limonen-robot/SuperMEXE02/hardware/README.md

# SuperMEXE02 回路図

KiCad 10で **[SuperMEXE02.kicad_pro](SuperMEXE02.kicad_pro)** を開き、回路図エディターを起動してください。回路図・プロジェクト専用シンボル・ライブラリー設定は同じフォルダーに揃っています。

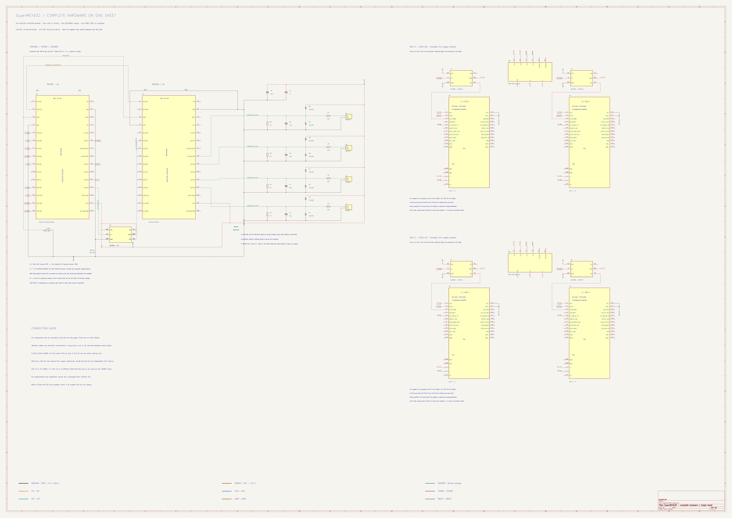
[picture p1: hardware/previews/sensor_frontend.png]
motor・sensorと基板間配線


**A0横の1ページに、すべての部品を統合しました。** 左側に両G431KB・4入力・共通リセット・UART・VCTリレー、右上にA/B軸と電源PS1、右下にC/D軸と電源PS2を配置しています。子ページはありません。同じラベル名は同じ電気接続を表します。KiCadまたはSVGを拡大して全ピンを確認してください。

[AZD-Kの全端子と配線](AZD_K_WIRING.md)／[基板間配線と未確定事項](INTERCONNECTS.md)。接続内容・部品定数・ピン割当は3ページ版から変更していません。ファームウェアとPCアプリも変更していません。

## 追加：すべての線をつないだ配線図

元の図の配置とラベル接続を残し、マイコンから全接続先まで線を追える[連続配線図](continuous_wiring/README.md)を別に追加しました。開くファイルは `continuous_wiring/SuperMEXE02_Continuous.kicad_pro` です。信号・電源・GNDをラベルで省略せず描いています。両図の電気的な接続内容は同じです。

## 文字だけで回路を再構成する仕様

**[回路・配線の再現仕様](HARDWARE_REPRODUCTION.md)** に、部品・型番・値、全278ピンと全34ネットの接続先、外部配線未記載131ピン、基板の向き、信号分類、配線手順をまとめました。[汎用JSON](wiring_manifest.json)、[接続CSV](wiring_connections.csv)、[部品CSV](hardware_bom.csv)を用意し、KiCad以外の回路CADや作図プログラムでも再構成できる形式にしています。元ファイルのハッシュは出典確認用の補足です。図面の外部接続を再現する資料であり、センサー型番やブレーキ・電源内部設定など実機の完全複製に必要な不足情報も明記しています。

## 配線の色

元図と連続配線図の両方で、信号の種類ごとに同じ色を使います。CW＝オレンジ、CCW＝青、センサー信号＝緑、ZHOME＝赤紫、VCT＝青緑、通信＝茶、リセット＝灰、電源＋＝赤、GND／電源−＝黒です。図の下端にも色見本を付けました。

同じ色でも別の電源・別の軸は別の接続です。配線と電源の分離は変更していません。色設定を読み込むには、このフォルダーの **SuperMEXE02.kicad_pro** から開いてください。[配色表と表示設定の説明](continuous_wiring/README.md#配線の色)を参照。

## 現在の範囲

2026-11-13の利用者説明と提供図をもとに、sensor側4入力と両マイコン間の実配線を記録しています。motorのCW/CCW、ZHOME用リレー4枚、MDR-100-24電源2台も記載しています。

| 図中名 | アプリ系列 | MCU入力 | 510 Ω直列 | 47 kΩ対GND | 0.1 µF対GND | 下側／上側1N4148 |
|---|---|---|---|---|---|---|
| sensor1 | a | PA_0 | R1 | R3 | C1 | D1／D3 |
| sensor2 | b | PA_1 | R2 | R4 | C2 | D2／D4 |
| sensor3 | c | PA_4 | R5 | R6 | C5 | D5／D6 |
| sensor4 | d | PA_5 | R7 | R8 | C6 | D7／D8 |

Pressure／Flow／Flow1はsensor1／2／3に変更し、同じ回路をsensor4として追加しました。圧力・流量などの意味と換算はアプリ側で設定します。C3=0.1 µF、C4=1 µFも提供図から引き継いでいます。

センサーのIN側は意図的な省略です。励起・センサー電源の配線は描いていません。両NUCLEOは現在USB給電です。両基板の3V3端子同士とGNDは共通化済みとの利用者説明を反映しました。USBを含む内部の給電経路は未検証です。

U1・U2は左CN4・右CN3をそれぞれ上から1〜15番で配置した基板シンボルです。Arduino名とMCU信号名を併記し、ピン番号は `4.n` = CN4-n、`3.n` = CN3-nです。[全端子対応表](NUCLEO_G431KB_PINOUT.md)に公式資料と接続先を示します。×印はこの図に外部配線を記載していない端子を示し、motorの未説明端子も含みます。S1〜S4は引き続き論理OUT/GNDだけの機能シンボルで、コネクターの物理番号は未指定です。フットプリントとPCBはまだ作っていません。PA_5をA4から使う際のソルダーブリッジとPB_7との共有状態は実ボードで確認が必要です。

## PB0の意味

現行[sensorコード](../G431KB_sensor/main.cpp)はPB_0を`InterruptIn`として使い、内部PullDownを設定して立ち上がりを検出します。VCTを受けた時刻を基準に、設定時間後のADC取得を予約します。初期遅延は310000 µs（310 ms）で、アプリから系列ごとに変更できます。100 Hzの通常取得は別に動作します。

実配線は **motor PA_0 → K1リレー基板の制御入力**、**共通3V3 → リレー接点 → sensor PB_0** です。PA0 HighでPB0に3.3 Vが入ります。motor自身のPB_0はB軸CWで、sensor PB_0とは別の信号です。

旧`ColonaryArtery_FlwPrsReader/main.cpp`では、PB_0の立ち上がりから310 ms後の左室圧（PA_5）を取得し、直近2回を平均して左室拡張末期圧相当値として扱っていました。現在はその時刻指定取得を汎用化しています。

## 写真から確認した機器

| 機器 | 判読した型番・表示 | まだ決めていないこと |
|---|---|---|
| DC電源 | MEAN WELL **MDR-100-24**、出力24 V・4 A（96 W）、入力100–240 VAC | PS1=A/B、PS2=C/Dを確認済み。AC/PE・ブレーキ配線は未記載 |
| リレー本体 | BESTEP **JQC3F-03VDC-C**（DC 3 Vコイル表記）、接点10 A・250 VAC／30 VDC等の表示 | 基板はQCCAN QC19004、3/3.3 V High入力・端子順を確認済み。内部ジャンパー設定は未確認 |

電源銘板の「DC OK max.30 VDC/1 A」は状態出力接点の定格です。24 V主出力の定格とは別です。[MEAN WELL公式仕様書](https://www.meanwell.com/Upload/PDF/MDR-100/MDR-100-SPEC.PDF)を参照。

リレーのコイル3 Vという表記だけで、モジュールの入力電圧や3.3 V GPIOとの適合性は確定しません。写真にはPC817C表記の部品も見えますが、絶縁構成・ジャンパー設定は未確認です。今回、VCT用1枚とZHOME用4枚を全6端子で表示しました。VCC/GNDは共通3V3/マイコンGNDへ接続し、接点側はVCTでは3V3、ZHOMEでは24 Vを扱います。内部のジャンパー設定は未確定です。

写真の根拠：2026-11-13に利用者が提供した電源銘板、リレー表面・裏面の3画像。型番の読み取りを記録したもので、基板全体の回路を推定したものではありません。

## ファイルと検証

- `SuperMEXE02.kicad_pro`：開くプロジェクト。
- `SuperMEXE02.kicad_sch`：全機器を配置した1ページの回路図。
- [AZD-K・リレー・電源の詳細](AZD_K_WIRING.md)：全端子表、IN-COMの説明、分配と未記載事項。
- `SuperMEXE02_IO.kicad_sym` / `sym-lib-table`：プロジェクト専用シンボルと相対パス設定。
- `sensor_channels.json`：チャンネルと部品番号・ヘッダーピンの対応。
- `nucleo_g431kb_pinout.json` / [全端子対応表](NUCLEO_G431KB_PINOUT.md)：全30端子の配置と信号名。
- `previews/`：1ページ全体のSVG・PNGプレビュー。
- `verify_connections.py`：KiCad XMLネットリストと確認済み配線の照合。
- [検証記録](checks/README.md)：ERCとネットリスト照合。

元の回路定数を再現した段階であり、センサーの出力範囲・保護性能・実配線の適合確認は今後行います。ファームウェアとPCアプリは今回変更していません。
