limonen-robot/SuperMEXE02/hardware/checks/README.md

# 回路図の確認記録

2026-11-13、KiCad 10.0.8で確認。

- 回路図読込み・SVG出力・XMLネットリスト出力：成功。
- ERC：エラー0、警告0。詳細は同梱レポート参照。
- XMLネットリスト照合：4つのADCネットが独立し、各ネットに対象GPIO・510 Ω抵抗出力・0.1 µF上端・47 kΩ上端・上下ダイオードの正しい極が接続されていることを確認。
- 各sensor OUTは対応する510 Ωの入力側だけへ接続。下側ダイオードのアノードはGND、上側ダイオードのカソードは3V3。
- C3/C4と上下クランプの共通3V3/GND接続も確認。
- Rev 0.2：G431KBまでの直接配線、共通3V3/GNDラインへ配置変更。変更前後の全11ネットについて、全ての部品ピンの接続先が完全一致することを確認。
- Rev 0.3：左右15本ずつ全30端子の重複・欠落なし。公式UM2397 Figure 12/Table 11に対応させ、既存の論理GPIO名から物理ヘッダー端子へ変換後、全11ネットの接続先を照合して一致。GNDはCN3-2とCN4-4の両方へ接続。
- Rev 0.4：U1/U2各30端子、D1→D0の2端子だけの接続、NRST2端子とSW1の接続、GND/3V3の共有、PA0→K1 IN・K1 NO→PB0の独立ネット、K1 COM→3V3をXMLネットリストで照合。4入力の既存ネットは完全一致。
- Rev 0.5：3ページの階層を含むERC 0/0。4台のCN4全24端子・CN1全5点、リレー5枚×6端子、電源2台×9端子を確認。12本の軸制御信号、各リレーNO→IN4、IN-COM5→各24 V−、CW/CCW−→マイコンGND、3つの基準線が別ネットであることを検証スクリプトで照合。
- Rev 0.6：階層を廃止してA0横1ページへ統合。XMLネットリストの全ネットを部品ピンの集合で比較し、3ページ版と完全一致。シート数1、部品番号の重複なし、ERC 0/0、配線照合スクリプト成功を確認。
- PNGで文字・部品・配線の配置を目視確認。

ERCは回路図上の接続検査であり、実配線の一致、ADC保護性能、基板の端子割当、センサー適合性を検証するものではない。VCTのリレー経由配線は利用者説明を反映。リレー基板は全6端子を反映済み。内部ジャンパー・USBを含む電源経路の適否・3.3 V直結パルス入力の適合性は未検証。

再確認例（このhardwareフォルダーで実行。KiCadのbinをPATHに追加）：

```powershell
kicad-cli sch erc --severity-all -o checks/sensor_frontend.erc.rpt SuperMEXE02.kicad_sch
kicad-cli sch export svg -o previews SuperMEXE02.kicad_sch
kicad-cli sch export netlist --format kicadxml -o sensor_frontend.net.xml SuperMEXE02.kicad_sch
```

配線照合の再実行：

```powershell
kicad-cli sch export netlist --format kicadxml -o hardware.net.xml SuperMEXE02.kicad_sch
python verify_connections.py hardware.net.xml
```

## 両図の配色統一（2026-11-14）

- 利用者指定：CWをオレンジ、CCWを青、センサーを緑に統一。ZHOMEはCWと区別するため赤紫へ変更。
- 元図・連続図それぞれの接続済み34ネットについて、KiCad出力のネットクラスが指定分類と一致することを確認。
- 両図の全ネットの部品ピン集合は、今回の変更前と完全一致。4軸GPIO・ADC・IN-COM5・UART・共通リセット・電源分離の既存検査に合格。
- 連続図は299本の線分だけによる接続検査にも合格。両図のERCはエラー0・警告0。
- SVGで全9色の配線出力を確認し、PNGで凡例と全体配置を目視確認。ファームウェア・PCアプリは変更なし。

## 文字による再現仕様の照合（2026-11-14）

- 対象回路コミット `f86a550`。今回は文書と汎用データのみ更新し、回路図・ライブラリー・ファームウェア・PCアプリは変更していない。
- `HARDWARE_REPRODUCTION.md`、`wiring_manifest.json`、`wiring_connections.csv`、`hardware_bom.csv`を照合。40部品・278ピン・接続済み34ネット・外部配線未記載131ピンの一致を確認。
- Markdown本文の全ネット表・部品別ピン表を読み戻してJSONと比較。CSVから読み戻した端子集合も一致し、部品CSVの抵抗値（Ω）・容量（F）・ピン数をJSONと比較して一致。
- 元図・連続図から新規出力したXMLネットリストと、文書データの全端子集合が完全一致。接続済みと未記載の重複・漏れなし。
- 両図・専用ライブラリー・ライブラリー参照設定の計8ファイルのSHA-256と、文書中の相対ファイルリンクを確認。
- 既存の配線検査と、連続図299線分の幾何学的接続検査にも合格。
- 外部端子付きモジュールとしての回路再構成を対象とする。内部回路・実パラメータ・機械構造などの不足情報は再現仕様の第10節に明記。
