limonen-robot/SuperMEXE02/hardware/HARDWARE_REPRODUCTION.md

# SuperMEXE02 回路・配線の文字による再現仕様

更新日：2026-11-14。対象回路はコミット `f86a550`。以後の文書追加で回路・コードは変更していない。

## 1. 再現できる範囲と読解規則

**KiCad・他の回路CAD・独自の作図プログラム・手描きのいずれでも再構成するための、ツール共通仕様**である。この文書だけで、現行図面に記録した部品・定数・全端子・全ネット・非接続表示・配色を再構成できる。ここでいう「同じ回路」は**図面に記録された外部端子間の電気的接続**を指す。実機の内部設定・機械構造を含めた完全複製は、第10節の不足情報が確定するまでできない。未知の値を一般的な接続やメーカー初期値で補わない。

- U1=sensor、U2=motor。両方ともST NUCLEO-G431KB。同じPA0等でも別基板のピンは別物。
- NUCLEOは部品面を上から見てUSBを上に置く。左CN4、右CN3、両列とも上から1〜15。`3.12`=CN3-12、`4.1`=CN4-1。MCUチップのパッケージ番号ではない。
- AZD-Kの`4.n`=CN4-n、`1.+`=CN1の＋、`1.-`=CN1の−、`1.MB1`等はメーカーの文字端子。CN4の図上配置は左1〜12、右13〜24（各列上から）。実コネクターの差込面/電線側の向きまで図から推定しない。
- ピン識別子は文字列として扱う。例えば`3.10`を小数3.1へ変換しない。CADの表示番号に使えない場合は別の内部番号を付け、元の文字列と1対1対応を残す。
- 内部回路を省略したモジュールは、ここに列挙した外部端子だけを持つ四角いブロックで再現してよい。専用シンボルライブラリーは必須でない。部品内部の結線・共通ピンは未記録の範囲まで補わない。
- 同じN番号の端子は**すべて同一ネット**。別のN番号同士を短絡しない。N番号は本書の識別子で、メーカー端子番号ではない。
- 第8節の各部品表には全ピンを1回ずつ記す。「未記載/×」は図面で外部接続を付けていない状態。実機で未使用とは断定しない。
- リレーのINとNO、VCCとCOMは別端子。リレーが閉じたときだけCOM–NOが導通する。図のネット表ではCOMとNOを永久短絡しない。内部コイル・フォトカプラ・ジャンパーは展開しない。
- ダイオード`1=K（カソード/帯側）`、`2=A（アノード）`。コンデンサーは図上無極性の2端子。抵抗の1/2は図面上の識別。
- PWR_FLAG・GND・+3V3の電源記号は実装部品でない。同じ名称の接続を定義する補助記号で、USB内部回路を意味しない。
- 色は信号分類。配線の実色を確認した記録ではなく、同色でも異なる電圧・異なるネットがある。

## 2. 機器・部品と図面識別

| 参照名 | 図面上の値/型番 | 役割 | シンボル |
|---|---|---|---|
| C1 | 0.1u | ADC入力からGNDへの0.1 µF | `Device:C` |
| C2 | 0.1u | ADC入力からGNDへの0.1 µF | `Device:C` |
| C3 | 0.1u | 3V3電源デカップリング | `Device:C` |
| C4 | 1u | 3V3電源デカップリング | `Device:C` |
| C5 | 0.1u | ADC入力からGNDへの0.1 µF | `Device:C` |
| C6 | 0.1u | ADC入力からGNDへの0.1 µF | `Device:C` |
| D1 | 1N4148 | GND側クランプ（A→GND） | `Diode:1N4148` |
| D2 | 1N4148 | GND側クランプ（A→GND） | `Diode:1N4148` |
| D3 | 1N4148 | 3V3側クランプ（K→3V3） | `Diode:1N4148` |
| D4 | 1N4148 | 3V3側クランプ（K→3V3） | `Diode:1N4148` |
| D5 | 1N4148 | GND側クランプ（A→GND） | `Diode:1N4148` |
| D6 | 1N4148 | 3V3側クランプ（K→3V3） | `Diode:1N4148` |
| D7 | 1N4148 | GND側クランプ（A→GND） | `Diode:1N4148` |
| D8 | 1N4148 | 3V3側クランプ（K→3V3） | `Diode:1N4148` |
| K1 | QC19004 / VCT | VCT用リレー基板 | `SuperMEXE02_IO:VCT_RELAY_MODULE` |
| K2 | QC19004 / ZHOME A | A軸ZHOME用リレー基板 | `SuperMEXE02_IO:VCT_RELAY_MODULE` |
| K3 | QC19004 / ZHOME B | B軸ZHOME用リレー基板 | `SuperMEXE02_IO:VCT_RELAY_MODULE` |
| K4 | QC19004 / ZHOME C | C軸ZHOME用リレー基板 | `SuperMEXE02_IO:VCT_RELAY_MODULE` |
| K5 | QC19004 / ZHOME D | D軸ZHOME用リレー基板 | `SuperMEXE02_IO:VCT_RELAY_MODULE` |
| PS1 | MDR-100-24 / AB | A/B軸用24 V電源 | `SuperMEXE02_IO:MDR_100_24` |
| PS2 | MDR-100-24 / CD | C/D軸用24 V電源 | `SuperMEXE02_IO:MDR_100_24` |
| R1 | 510 | 510 Ω直列抵抗 | `Device:R` |
| R2 | 510 | 510 Ω直列抵抗 | `Device:R` |
| R3 | 47k | 47 kΩ対GND抵抗 | `Device:R` |
| R4 | 47k | 47 kΩ対GND抵抗 | `Device:R` |
| R5 | 510 | 510 Ω直列抵抗 | `Device:R` |
| R6 | 47k | 47 kΩ対GND抵抗 | `Device:R` |
| R7 | 510 | 510 Ω直列抵抗 | `Device:R` |
| R8 | 47k | 47 kΩ対GND抵抗 | `Device:R` |
| S1 | sensor1 | sensor1の論理OUT/GND端子。実センサー型番・コネクター未指定 | `SuperMEXE02_IO:SensorInterface` |
| S2 | sensor2 | sensor2の論理OUT/GND端子。実センサー型番・コネクター未指定 | `SuperMEXE02_IO:SensorInterface` |
| S3 | sensor3 | sensor3の論理OUT/GND端子。実センサー型番・コネクター未指定 | `SuperMEXE02_IO:SensorInterface` |
| S4 | sensor4 | sensor4の論理OUT/GND端子。実センサー型番・コネクター未指定 | `SuperMEXE02_IO:SensorInterface` |
| SW1 | RESET BOTH | 両マイコン共通リセット用・通常開押しボタン | `Switch:SW_Push` |
| U1 | NUCLEO-G431KB | sensor用マイコン | `SuperMEXE02_IO:NUCLEO_G431KB_FULL` |
| U2 | NUCLEO-G431KB (motor) | motor用マイコン | `SuperMEXE02_IO:NUCLEO_G431KB_MOTOR_FULL` |
| U3 | AZD-K / A | A軸ドライバ | `SuperMEXE02_IO:AZD_K` |
| U4 | AZD-K / B | B軸ドライバ | `SuperMEXE02_IO:AZD_K` |
| U5 | AZD-K / C | C軸ドライバ | `SuperMEXE02_IO:AZD_K` |
| U6 | AZD-K / D | D軸ドライバ | `SuperMEXE02_IO:AZD_K` |

実機に対応する追加情報：

- U3〜U6はオリエンタルモーターAZD-K（AZD-KDではない）。各軸の直動機構は利用者指定のDRS2/AZ付き `DRSM42RG-04A2AZMK`。アクチュエータそのものを電気図の追加U番号として数えない。
- K1〜K5はQCCAN QC19004、ASIN B09X1P3YHLの1ch・3/3.3 V・High入力リレー基板。本体表示BESTEP JQC3F-03VDC-C。裸リレーをGPIO直結する意味ではない。部品面・制御側を左とした物理順は左上→下=VCC,IN,GND、右上→下=NC,COM,NO。1〜6という物理番号は付けていない。
- PS1/PS2はMEAN WELL MDR-100-24、24 V/4 A（96 W）。上側左→右=+V,+V,−V,−V,DC OK,DC OK、下側左→右=PE,N,L。本書では上側を+V1,+V2,−V1,−V2,OK1,OK2と識別する。同一電源内の+V1/+V2、−V1/−V2は内部共通。
- 抵抗は510 Ω×4、47 kΩ×4。C1/C2/C3/C5/C6=0.1 µF×5、C4=1 µF×1、1N4148×8。許容差・定格・実装形式は未指定。

## 3. 接続を組み立てる順序

1. U1/U2と全端子を第8節どおり定義する。両NUCLEOはST-LINK側USBからそれぞれ給電しPCへつなぐ構成。USB内部は省略する。
2. 共通+3V3とマイコンGNDを接続する。U1/U2のCN3-14を共有し、CN3-2/CN4-4を共通GNDとする。USBと3V3共有は既存配線の記録で、内部給電設定の検証済み設計ではない。
3. sensor入力4系統を第4節どおり組む。センサーIN・給電は省略範囲であり、+3V3へ勝手に接続しない。
4. motor GPIO→CW+/CCW+、CW−/CCW−→マイコンGNDを接続する。途中の外付け抵抗・トランジスタ・変換基板はない。
5. 各軸のZHOME用リレーを接続する。VCC/GNDはマイコン側、COM/NOは24 V側。
6. PS1をA/B、PS2をC/Dへ分配する。0V_AB、0V_CD、マイコンGNDの3種類は相互に接続しない。
7. K1によるVCT同期、U1 D1→U2 D0の線、NRST共通スイッチを接続する。
8. 第7節のネットを全件照合し、第8節の未記載端子へ追加配線していないことを確認する。

## 4. アナログ入力4系統

| 系列 | OUT→直列抵抗 | ADC先（U1） | ADC点→GND | 下クランプ（K→ADC/A→GND） | 上クランプ（K→3V3/A→ADC） |
|---|---|---|---|---|---|
| sensor1=a | S1.OUT→R1.1、R1.2→ADC点 | CN3-12 / A0 / PA0 | R3=47 kΩ、C1=0.1 µF | D1 | D3 |
| sensor2=b | S2.OUT→R2.1、R2.2→ADC点 | CN3-11 / A1 / PA1 | R4=47 kΩ、C2=0.1 µF | D2 | D4 |
| sensor3=c | S3.OUT→R5.1、R5.2→ADC点 | CN3-9 / A3 / PA4 | R6=47 kΩ、C5=0.1 µF | D5 | D6 |
| sensor4=d | S4.OUT→R7.1、R7.2→ADC点 | CN3-8 / A4 / PA5 | R8=47 kΩ、C6=0.1 µF | D7 | D8 |

全直列抵抗は510 Ω。各S.GNDはマイコンGND。C3（0.1 µF）とC4（1 µF）は各1番が共通3V3、各2番がGND。圧力/流量の用途は固定せずa〜dに対応する。PA5と端子A4を一致させる実ソルダーブリッジ設定は未記録。

## 5. モータ・ZHOME・電源の割当

| 軸 | CW（U2→ドライバCN4-1） | CCW（U2→CN4-2） | ZHOME（U2→リレーIN） | ドライバ/リレー/電源 |
|---|---|---|---|---|
| A | CN3-11 / A1 / PA1 | CN3-9 / A3 / PA4 | CN4-15 / D12 / PB4 | U3 / K2 / PS1 |
| B | CN4-6 / D3 / PB0 | CN4-12 / D9 / PA8 | CN4-14 / D11 / PB5 | U4 / K3 / PS1 |
| C | CN4-9 / D6 / PB6 | CN4-7 / D4 / PB7 | CN3-6 / A6 / PA7 | U5 / K4 / PS2 |
| D | CN4-13 / D10 / PA11 | CN4-5 / D2 / PA12 | CN4-8 / D5 / PA15 | U6 / K5 / PS2 |

全軸でCN4-13=CW−とCN4-14=CCW−はマイコンGND。リレーVCC=共通3V3、GND=マイコンGND、COM=対応電源の24 V＋、NO=ドライバCN4-3/IN4/ZHOME。CN4-5/IN-COM[4–7]とCN1−は対応電源の24 V−へ、CN1＋は対応24 V＋へ接続する。**CN4-22/GNDではなくCN4-5へ戻す。** CN4-17/IN-COM[8–9]もCN4-22も、この図では外部配線未記載。

図面上の端子識別子で表した分配は、PS1の+V1からU3.CN1＋とK2.COM、+V2からU4.CN1＋とK3.COM、−V1からU3.CN1−とU3.CN4-5、−V2からU4.CN1−とU4.CN4-5。PS2も同様にU5/K4、U6/K5へ接続する。1穴2本の実配線を表現しているが、実機の左右どちらの穴を各軸へ割り当てたかは未記録。同一電源内の同極穴は電気的に共通。線径や端末処理・端子仕様との適合は未確認。元図は同名ラベル、連続図は電源枠内の線で内部共通を表現する。

採用換算は実験的に確認された2500 pulse/mm（1 pulse=0.0004 mm）、CW正/CCW負。旧根拠4 mm/rev・10000 pulse/revを機械リードや別のギヤ設定へ置き換えない。機械リード・電子ギヤ設定・実方向の未確定事項は残る。

## 6. 基板間・PCとの接続

- VCT制御：U2.CN3-12/A0/PA0→K1.IN。K1.VCCとK1.COM=共通3V3、K1.GND=マイコンGND、K1.NO→U1.CN4-6/D3/PB0。K1.NCは未接続表示。PA0 Highで接点が閉じ3.3 Vがsensor PB0へ入る。**PA0→PB0の直結線を追加しない。**
- UART：U1.CN4-1/D1/PA9→U2.CN4-2/D0/PA10の1本。逆方向の線は記録なし。現行コードはこの線を使用せず、値はPC経由。元の冠流量システムの線伝送と混同しない。
- リセット：U1.CN4-3とU2.CN4-3をSW1.1へ、SW1.2をマイコンGNDへ。通常開、押すとLowとなり両ボードをリセット。右CN3-3は図上外部配線未記載で、左NRSTに加えて外部ジャンパーを追加しない。
- PC：両ボードへそれぞれUSB/ST-LINK VCP。motorはMOTOR_V6、sensorはSENSOR_V1、各115200 bps/8N1/フロー制御なし。COM番号・ドライブ文字は固定しない。
- sensor PB0の入力PullDownはファームウェア設定。図面に外付けプルダウン抵抗を追加しない。接点の遅延・チャタリング補正は現行コードにない。

## 7. 全接続ネット一覧（接続先の省略なし）

接続済み34ネット。各セルはそのネットの端子を全て列挙する。ネット名に含まれる先頭`/`はKiCadのシートパス。元図と連続図は自動生成名やローカル名が違うことがあるが、部品ピン集合は同じ。

| ID | 元図のネット名 | 連続図のネット名 | 種別/色 | 全接続端子 |
|---|---|---|---|---|
| N01 | `+3V3` | `+3V3` | POWER/赤 | `C3.1`、`C4.1`、`D3.1`、`D4.1`、`D6.1`、`D8.1`、`K1.COM`、`K1.VCC`、`K2.VCC`、`K3.VCC`、`K4.VCC`、`K5.VCC`、`U1.3.14`、`U2.3.14` |
| N02 | `/0V_AB` | `/0V_AB` | GROUND/黒 | `PS1.-V1`、`PS1.-V2`、`U3.1.-`、`U3.4.5`、`U4.1.-`、`U4.4.5` |
| N03 | `/0V_CD` | `/0V_CD` | GROUND/黒 | `PS2.-V1`、`PS2.-V2`、`U5.1.-`、`U5.4.5`、`U6.1.-`、`U6.4.5` |
| N04 | `/24V_AB` | `/24V_AB` | POWER/赤 | `K2.COM`、`K3.COM`、`PS1.+V1`、`PS1.+V2`、`U3.1.+`、`U4.1.+` |
| N05 | `/24V_CD` | `/24V_CD` | POWER/赤 | `K4.COM`、`K5.COM`、`PS2.+V1`、`PS2.+V2`、`U5.1.+`、`U6.1.+` |
| N06 | `/NRST_BOTH` | `Net-(SW1-Pad1)` | RESET/灰 | `SW1.1`、`U1.4.3`、`U2.4.3` |
| N07 | `/SENSOR1_ADC_PA0` | `Net-(D1-K)` | SENSOR/緑 | `C1.1`、`D1.1`、`D3.2`、`R1.2`、`R3.1`、`U1.3.12` |
| N08 | `/SENSOR2_ADC_PA1` | `Net-(D2-K)` | SENSOR/緑 | `C2.1`、`D2.1`、`D4.2`、`R2.2`、`R4.1`、`U1.3.11` |
| N09 | `/SENSOR3_ADC_PA4` | `Net-(D5-K)` | SENSOR/緑 | `C5.1`、`D5.1`、`D6.2`、`R5.2`、`R6.1`、`U1.3.9` |
| N10 | `/SENSOR4_ADC_PA5` | `Net-(D7-K)` | SENSOR/緑 | `C6.1`、`D7.1`、`D8.2`、`R7.2`、`R8.1`、`U1.3.8` |
| N11 | `/SENSOR_D1_TO_MOTOR_D0` | `/SENSOR_D1_TO_MOTOR_D0` | UART/茶 | `U1.4.1`、`U2.4.2` |
| N12 | `/VCT_RELAY_CTRL` | `/VCT_RELAY_IN` | VCT/青緑 | `K1.IN`、`U2.3.12` |
| N13 | `/VCT_TO_SENSOR_PB0` | `/VCT_SENSOR` | VCT/青緑 | `K1.NO`、`U1.4.6` |
| N14 | `A_CCW` | `/A_CCW` | CCW/青 | `U2.3.9`、`U3.4.2` |
| N15 | `A_CW` | `/A_CW` | CW/オレンジ | `U2.3.11`、`U3.4.1` |
| N16 | `A_HOME` | `/A_HOME` | ZHOME/赤紫 | `K2.IN`、`U2.4.15` |
| N17 | `B_CCW` | `/B_CCW` | CCW/青 | `U2.4.12`、`U4.4.2` |
| N18 | `B_CW` | `/B_CW` | CW/オレンジ | `U2.4.6`、`U4.4.1` |
| N19 | `B_HOME` | `/B_HOME` | ZHOME/赤紫 | `K3.IN`、`U2.4.14` |
| N20 | `C_CCW` | `/C_CCW` | CCW/青 | `U2.4.7`、`U5.4.2` |
| N21 | `C_CW` | `/C_CW` | CW/オレンジ | `U2.4.9`、`U5.4.1` |
| N22 | `C_HOME` | `/C_HOME` | ZHOME/赤紫 | `K4.IN`、`U2.3.6` |
| N23 | `D_CCW` | `/D_CCW` | CCW/青 | `U2.4.5`、`U6.4.2` |
| N24 | `D_CW` | `/D_CW` | CW/オレンジ | `U2.4.13`、`U6.4.1` |
| N25 | `D_HOME` | `/D_HOME` | ZHOME/赤紫 | `K5.IN`、`U2.4.8` |
| N26 | `GND` | `GND` | GROUND/黒 | `C1.2`、`C2.2`、`C3.2`、`C4.2`、`C5.2`、`C6.2`、`D1.2`、`D2.2`、`D5.2`、`D7.2`、`K1.GND`、`K2.GND`、`K3.GND`、`K4.GND`、`K5.GND`、`R3.2`、`R4.2`、`R6.2`、`R8.2`、`S1.GND`、`S2.GND`、`S3.GND`、`S4.GND`、`SW1.2`、`U1.3.2`、`U1.4.4`、`U2.3.2`、`U2.4.4`、`U3.4.13`、`U3.4.14`、`U4.4.13`、`U4.4.14`、`U5.4.13`、`U5.4.14`、`U6.4.13`、`U6.4.14` |
| N27 | `Net-(R1-Pad1)` | `Net-(R1-Pad1)` | SENSOR/緑 | `R1.1`、`S1.OUT` |
| N28 | `Net-(R2-Pad1)` | `Net-(R2-Pad1)` | SENSOR/緑 | `R2.1`、`S2.OUT` |
| N29 | `Net-(R5-Pad1)` | `Net-(R5-Pad1)` | SENSOR/緑 | `R5.1`、`S3.OUT` |
| N30 | `Net-(R7-Pad1)` | `Net-(R7-Pad1)` | SENSOR/緑 | `R7.1`、`S4.OUT` |
| N31 | `Net-(U3-IN4/ZHOME)` | `/A_ZHOME_24V` | ZHOME/赤紫 | `K2.NO`、`U3.4.3` |
| N32 | `Net-(U4-IN4/ZHOME)` | `/B_ZHOME_24V` | ZHOME/赤紫 | `K3.NO`、`U4.4.3` |
| N33 | `Net-(U5-IN4/ZHOME)` | `/C_ZHOME_24V` | ZHOME/赤紫 | `K4.NO`、`U5.4.3` |
| N34 | `Net-(U6-IN4/ZHOME)` | `/D_ZHOME_24V` | ZHOME/赤紫 | `K5.NO`、`U6.4.3` |

## 8. 部品ごとの全端子表

実装/機能シンボル40個、外部ピン278本を網羅。うち外部配線未記載/×は131本。電源記号は数に含まない。

### C1 — 0.1u（ADC入力からGNDへの0.1 µF）

| ピン識別子 | 図面信号名 | ネット/状態 |
|---|---|---|
| `1` |  | N07 |
| `2` |  | N26 |

### C2 — 0.1u（ADC入力からGNDへの0.1 µF）

| ピン識別子 | 図面信号名 | ネット/状態 |
|---|---|---|
| `1` |  | N08 |
| `2` |  | N26 |

### C3 — 0.1u（3V3電源デカップリング）

| ピン識別子 | 図面信号名 | ネット/状態 |
|---|---|---|
| `1` |  | N01 |
| `2` |  | N26 |

### C4 — 1u（3V3電源デカップリング）

| ピン識別子 | 図面信号名 | ネット/状態 |
|---|---|---|
| `1` |  | N01 |
| `2` |  | N26 |

### C5 — 0.1u（ADC入力からGNDへの0.1 µF）

| ピン識別子 | 図面信号名 | ネット/状態 |
|---|---|---|
| `1` |  | N09 |
| `2` |  | N26 |

### C6 — 0.1u（ADC入力からGNDへの0.1 µF）

| ピン識別子 | 図面信号名 | ネット/状態 |
|---|---|---|
| `1` |  | N10 |
| `2` |  | N26 |

### D1 — 1N4148（GND側クランプ（A→GND））

| ピン識別子 | 図面信号名 | ネット/状態 |
|---|---|---|
| `1` | K | N07 |
| `2` | A | N26 |

### D2 — 1N4148（GND側クランプ（A→GND））

| ピン識別子 | 図面信号名 | ネット/状態 |
|---|---|---|
| `1` | K | N08 |
| `2` | A | N26 |

### D3 — 1N4148（3V3側クランプ（K→3V3））

| ピン識別子 | 図面信号名 | ネット/状態 |
|---|---|---|
| `1` | K | N01 |
| `2` | A | N07 |

### D4 — 1N4148（3V3側クランプ（K→3V3））

| ピン識別子 | 図面信号名 | ネット/状態 |
|---|---|---|
| `1` | K | N01 |
| `2` | A | N08 |

### D5 — 1N4148（GND側クランプ（A→GND））

| ピン識別子 | 図面信号名 | ネット/状態 |
|---|---|---|
| `1` | K | N09 |
| `2` | A | N26 |

### D6 — 1N4148（3V3側クランプ（K→3V3））

| ピン識別子 | 図面信号名 | ネット/状態 |
|---|---|---|
| `1` | K | N01 |
| `2` | A | N09 |

### D7 — 1N4148（GND側クランプ（A→GND））

| ピン識別子 | 図面信号名 | ネット/状態 |
|---|---|---|
| `1` | K | N10 |
| `2` | A | N26 |

### D8 — 1N4148（3V3側クランプ（K→3V3））

| ピン識別子 | 図面信号名 | ネット/状態 |
|---|---|---|
| `1` | K | N01 |
| `2` | A | N10 |

### K1 — QC19004 / VCT（VCT用リレー基板）

| ピン識別子 | 図面信号名 | ネット/状態 |
|---|---|---|
| `VCC` | VCC | N01 |
| `IN` | IN | N12 |
| `GND` | GND | N26 |
| `NC` | NC | 未記載/×（追加配線しない） |
| `COM` | COM | N01 |
| `NO` | NO | N13 |

### K2 — QC19004 / ZHOME A（A軸ZHOME用リレー基板）

| ピン識別子 | 図面信号名 | ネット/状態 |
|---|---|---|
| `VCC` | VCC | N01 |
| `IN` | IN | N16 |
| `GND` | GND | N26 |
| `NC` | NC | 未記載/×（追加配線しない） |
| `COM` | COM | N04 |
| `NO` | NO | N31 |

### K3 — QC19004 / ZHOME B（B軸ZHOME用リレー基板）

| ピン識別子 | 図面信号名 | ネット/状態 |
|---|---|---|
| `VCC` | VCC | N01 |
| `IN` | IN | N19 |
| `GND` | GND | N26 |
| `NC` | NC | 未記載/×（追加配線しない） |
| `COM` | COM | N04 |
| `NO` | NO | N32 |

### K4 — QC19004 / ZHOME C（C軸ZHOME用リレー基板）

| ピン識別子 | 図面信号名 | ネット/状態 |
|---|---|---|
| `VCC` | VCC | N01 |
| `IN` | IN | N22 |
| `GND` | GND | N26 |
| `NC` | NC | 未記載/×（追加配線しない） |
| `COM` | COM | N05 |
| `NO` | NO | N33 |

### K5 — QC19004 / ZHOME D（D軸ZHOME用リレー基板）

| ピン識別子 | 図面信号名 | ネット/状態 |
|---|---|---|
| `VCC` | VCC | N01 |
| `IN` | IN | N25 |
| `GND` | GND | N26 |
| `NC` | NC | 未記載/×（追加配線しない） |
| `COM` | COM | N05 |
| `NO` | NO | N34 |

### PS1 — MDR-100-24 / AB（A/B軸用24 V電源）

| ピン識別子 | 図面信号名 | ネット/状態 |
|---|---|---|
| `+V1` | +V1 | N04 |
| `PE` | PE | 未記載/×（追加配線しない） |
| `+V2` | +V2 | N04 |
| `-V1` | -V1 | N02 |
| `N` | N | 未記載/×（追加配線しない） |
| `-V2` | -V2 | N02 |
| `OK1` | DC_OK1 | 未記載/×（追加配線しない） |
| `L` | L | 未記載/×（追加配線しない） |
| `OK2` | DC_OK2 | 未記載/×（追加配線しない） |

### PS2 — MDR-100-24 / CD（C/D軸用24 V電源）

| ピン識別子 | 図面信号名 | ネット/状態 |
|---|---|---|
| `+V1` | +V1 | N05 |
| `PE` | PE | 未記載/×（追加配線しない） |
| `+V2` | +V2 | N05 |
| `-V1` | -V1 | N03 |
| `N` | N | 未記載/×（追加配線しない） |
| `-V2` | -V2 | N03 |
| `OK1` | DC_OK1 | 未記載/×（追加配線しない） |
| `L` | L | 未記載/×（追加配線しない） |
| `OK2` | DC_OK2 | 未記載/×（追加配線しない） |

### R1 — 510（510 Ω直列抵抗）

| ピン識別子 | 図面信号名 | ネット/状態 |
|---|---|---|
| `1` |  | N27 |
| `2` |  | N07 |

### R2 — 510（510 Ω直列抵抗）

| ピン識別子 | 図面信号名 | ネット/状態 |
|---|---|---|
| `1` |  | N28 |
| `2` |  | N08 |

### R3 — 47k（47 kΩ対GND抵抗）

| ピン識別子 | 図面信号名 | ネット/状態 |
|---|---|---|
| `1` |  | N07 |
| `2` |  | N26 |

### R4 — 47k（47 kΩ対GND抵抗）

| ピン識別子 | 図面信号名 | ネット/状態 |
|---|---|---|
| `1` |  | N08 |
| `2` |  | N26 |

### R5 — 510（510 Ω直列抵抗）

| ピン識別子 | 図面信号名 | ネット/状態 |
|---|---|---|
| `1` |  | N29 |
| `2` |  | N09 |

### R6 — 47k（47 kΩ対GND抵抗）

| ピン識別子 | 図面信号名 | ネット/状態 |
|---|---|---|
| `1` |  | N09 |
| `2` |  | N26 |

### R7 — 510（510 Ω直列抵抗）

| ピン識別子 | 図面信号名 | ネット/状態 |
|---|---|---|
| `1` |  | N30 |
| `2` |  | N10 |

### R8 — 47k（47 kΩ対GND抵抗）

| ピン識別子 | 図面信号名 | ネット/状態 |
|---|---|---|
| `1` |  | N10 |
| `2` |  | N26 |

### S1 — sensor1（sensor1の論理OUT/GND端子。実センサー型番・コネクター未指定）

| ピン識別子 | 図面信号名 | ネット/状態 |
|---|---|---|
| `OUT` | OUT | N27 |
| `GND` | GND | N26 |

### S2 — sensor2（sensor2の論理OUT/GND端子。実センサー型番・コネクター未指定）

| ピン識別子 | 図面信号名 | ネット/状態 |
|---|---|---|
| `OUT` | OUT | N28 |
| `GND` | GND | N26 |

### S3 — sensor3（sensor3の論理OUT/GND端子。実センサー型番・コネクター未指定）

| ピン識別子 | 図面信号名 | ネット/状態 |
|---|---|---|
| `OUT` | OUT | N29 |
| `GND` | GND | N26 |

### S4 — sensor4（sensor4の論理OUT/GND端子。実センサー型番・コネクター未指定）

| ピン識別子 | 図面信号名 | ネット/状態 |
|---|---|---|
| `OUT` | OUT | N30 |
| `GND` | GND | N26 |

### SW1 — RESET BOTH（両マイコン共通リセット用・通常開押しボタン）

| ピン識別子 | 図面信号名 | ネット/状態 |
|---|---|---|
| `1` | 1 | N06 |
| `2` | 2 | N26 |

### U1 — NUCLEO-G431KB（sensor用マイコン）

| ピン識別子 | 図面信号名 | ネット/状態 |
|---|---|---|
| `4.1` | D1/PA9 | N11 |
| `4.2` | D0/PA10 | 未記載/×（追加配線しない） |
| `4.3` | NRST | N06 |
| `4.4` | GND | N26 |
| `4.5` | D2/PA12 | 未記載/×（追加配線しない） |
| `4.6` | D3/PB0 | N13 |
| `4.7` | D4/PB7 | 未記載/×（追加配線しない） |
| `4.8` | D5/PA15 | 未記載/×（追加配線しない） |
| `4.9` | D6/PB6 | 未記載/×（追加配線しない） |
| `4.10` | D7/PF0 | 未記載/×（追加配線しない） |
| `4.11` | D8/PF1 | 未記載/×（追加配線しない） |
| `4.12` | D9/PA8 | 未記載/×（追加配線しない） |
| `4.13` | D10/PA11 | 未記載/×（追加配線しない） |
| `4.14` | D11/PB5 | 未記載/×（追加配線しない） |
| `4.15` | D12/PB4 | 未記載/×（追加配線しない） |
| `3.1` | VIN | 未記載/×（追加配線しない） |
| `3.2` | GND | N26 |
| `3.3` | NRST | 未記載/×（追加配線しない） |
| `3.4` | +5V | 未記載/×（追加配線しない） |
| `3.5` | A7/PA2 | 未記載/×（追加配線しない） |
| `3.6` | A6/PA7 | 未記載/×（追加配線しない） |
| `3.7` | A5/PA6/PA15 | 未記載/×（追加配線しない） |
| `3.8` | A4/PA5/PB7 | N10 |
| `3.9` | A3/PA4 | N09 |
| `3.10` | A2/PA3 | 未記載/×（追加配線しない） |
| `3.11` | A1/PA1 | N08 |
| `3.12` | A0/PA0 | N07 |
| `3.13` | AREF/AVDD | 未記載/×（追加配線しない） |
| `3.14` | +3V3 | N01 |
| `3.15` | D13/PB3/PB8 | 未記載/×（追加配線しない） |

### U2 — NUCLEO-G431KB (motor)（motor用マイコン）

| ピン識別子 | 図面信号名 | ネット/状態 |
|---|---|---|
| `4.1` | D1/PA9 | 未記載/×（追加配線しない） |
| `4.2` | D0/PA10 | N11 |
| `4.3` | NRST | N06 |
| `4.4` | GND | N26 |
| `4.5` | D2/PA12 | N23 |
| `4.6` | D3/PB0 | N18 |
| `4.7` | D4/PB7 | N20 |
| `4.8` | D5/PA15 | N25 |
| `4.9` | D6/PB6 | N21 |
| `4.10` | D7/PF0 | 未記載/×（追加配線しない） |
| `4.11` | D8/PF1 | 未記載/×（追加配線しない） |
| `4.12` | D9/PA8 | N17 |
| `4.13` | D10/PA11 | N24 |
| `4.14` | D11/PB5 | N19 |
| `4.15` | D12/PB4 | N16 |
| `3.1` | VIN | 未記載/×（追加配線しない） |
| `3.2` | GND | N26 |
| `3.3` | NRST | 未記載/×（追加配線しない） |
| `3.4` | +5V | 未記載/×（追加配線しない） |
| `3.5` | A7/PA2 | 未記載/×（追加配線しない） |
| `3.6` | A6/PA7 | N22 |
| `3.7` | A5/PA6/PA15 | 未記載/×（追加配線しない） |
| `3.8` | A4/PA5/PB7 | 未記載/×（追加配線しない） |
| `3.9` | A3/PA4 | N14 |
| `3.10` | A2/PA3 | 未記載/×（追加配線しない） |
| `3.11` | A1/PA1 | N15 |
| `3.12` | A0/PA0 | N12 |
| `3.13` | AREF/AVDD | 未記載/×（追加配線しない） |
| `3.14` | +3V3 | N01 |
| `3.15` | D13/PB3/PB8 | 未記載/×（追加配線しない） |

### U3 — AZD-K / A（A軸ドライバ）

| ピン識別子 | 図面信号名 | ネット/状態 |
|---|---|---|
| `4.1` | CW+ | N15 |
| `4.2` | CCW+ | N14 |
| `4.3` | IN4/ZHOME | N31 |
| `4.4` | IN6/STOP | 未記載/×（追加配線しない） |
| `4.5` | IN-COM_[4-7] | N02 |
| `4.6` | IN8/FW-JOG | 未記載/×（追加配線しない） |
| `4.7` | OUT0/HOME-END | 未記載/×（追加配線しない） |
| `4.8` | OUT2/PLS-RDY | 未記載/×（追加配線しない） |
| `4.9` | OUT4/MOVE | 未記載/×（追加配線しない） |
| `4.10` | OUT-COM | 未記載/×（追加配線しない） |
| `4.11` | ASG+ | 未記載/×（追加配線しない） |
| `4.12` | BSG+ | 未記載/×（追加配線しない） |
| `1.MB1` | MB1 | 未記載/×（追加配線しない） |
| `1.MB2` | MB2 | 未記載/×（追加配線しない） |
| `1.+` | + | N04 |
| `1.-` | - | N02 |
| `1.FG` | FG | 未記載/×（追加配線しない） |
| `4.13` | CW- | N26 |
| `4.14` | CCW- | N26 |
| `4.15` | IN5/FREE | 未記載/×（追加配線しない） |
| `4.16` | IN7/ALM-RST | 未記載/×（追加配線しない） |
| `4.17` | IN-COM_[8-9] | 未記載/×（追加配線しない） |
| `4.18` | IN9/RV-JOG | 未記載/×（追加配線しない） |
| `4.19` | OUT1/IN-POS | 未記載/×（追加配線しない） |
| `4.20` | OUT3/READY | 未記載/×（追加配線しない） |
| `4.21` | OUT5/ALM-B | 未記載/×（追加配線しない） |
| `4.22` | GND | 未記載/×（追加配線しない） |
| `4.23` | ASG- | 未記載/×（追加配線しない） |
| `4.24` | BSG- | 未記載/×（追加配線しない） |

### U4 — AZD-K / B（B軸ドライバ）

| ピン識別子 | 図面信号名 | ネット/状態 |
|---|---|---|
| `4.1` | CW+ | N18 |
| `4.2` | CCW+ | N17 |
| `4.3` | IN4/ZHOME | N32 |
| `4.4` | IN6/STOP | 未記載/×（追加配線しない） |
| `4.5` | IN-COM_[4-7] | N02 |
| `4.6` | IN8/FW-JOG | 未記載/×（追加配線しない） |
| `4.7` | OUT0/HOME-END | 未記載/×（追加配線しない） |
| `4.8` | OUT2/PLS-RDY | 未記載/×（追加配線しない） |
| `4.9` | OUT4/MOVE | 未記載/×（追加配線しない） |
| `4.10` | OUT-COM | 未記載/×（追加配線しない） |
| `4.11` | ASG+ | 未記載/×（追加配線しない） |
| `4.12` | BSG+ | 未記載/×（追加配線しない） |
| `1.MB1` | MB1 | 未記載/×（追加配線しない） |
| `1.MB2` | MB2 | 未記載/×（追加配線しない） |
| `1.+` | + | N04 |
| `1.-` | - | N02 |
| `1.FG` | FG | 未記載/×（追加配線しない） |
| `4.13` | CW- | N26 |
| `4.14` | CCW- | N26 |
| `4.15` | IN5/FREE | 未記載/×（追加配線しない） |
| `4.16` | IN7/ALM-RST | 未記載/×（追加配線しない） |
| `4.17` | IN-COM_[8-9] | 未記載/×（追加配線しない） |
| `4.18` | IN9/RV-JOG | 未記載/×（追加配線しない） |
| `4.19` | OUT1/IN-POS | 未記載/×（追加配線しない） |
| `4.20` | OUT3/READY | 未記載/×（追加配線しない） |
| `4.21` | OUT5/ALM-B | 未記載/×（追加配線しない） |
| `4.22` | GND | 未記載/×（追加配線しない） |
| `4.23` | ASG- | 未記載/×（追加配線しない） |
| `4.24` | BSG- | 未記載/×（追加配線しない） |

### U5 — AZD-K / C（C軸ドライバ）

| ピン識別子 | 図面信号名 | ネット/状態 |
|---|---|---|
| `4.1` | CW+ | N21 |
| `4.2` | CCW+ | N20 |
| `4.3` | IN4/ZHOME | N33 |
| `4.4` | IN6/STOP | 未記載/×（追加配線しない） |
| `4.5` | IN-COM_[4-7] | N03 |
| `4.6` | IN8/FW-JOG | 未記載/×（追加配線しない） |
| `4.7` | OUT0/HOME-END | 未記載/×（追加配線しない） |
| `4.8` | OUT2/PLS-RDY | 未記載/×（追加配線しない） |
| `4.9` | OUT4/MOVE | 未記載/×（追加配線しない） |
| `4.10` | OUT-COM | 未記載/×（追加配線しない） |
| `4.11` | ASG+ | 未記載/×（追加配線しない） |
| `4.12` | BSG+ | 未記載/×（追加配線しない） |
| `1.MB1` | MB1 | 未記載/×（追加配線しない） |
| `1.MB2` | MB2 | 未記載/×（追加配線しない） |
| `1.+` | + | N05 |
| `1.-` | - | N03 |
| `1.FG` | FG | 未記載/×（追加配線しない） |
| `4.13` | CW- | N26 |
| `4.14` | CCW- | N26 |
| `4.15` | IN5/FREE | 未記載/×（追加配線しない） |
| `4.16` | IN7/ALM-RST | 未記載/×（追加配線しない） |
| `4.17` | IN-COM_[8-9] | 未記載/×（追加配線しない） |
| `4.18` | IN9/RV-JOG | 未記載/×（追加配線しない） |
| `4.19` | OUT1/IN-POS | 未記載/×（追加配線しない） |
| `4.20` | OUT3/READY | 未記載/×（追加配線しない） |
| `4.21` | OUT5/ALM-B | 未記載/×（追加配線しない） |
| `4.22` | GND | 未記載/×（追加配線しない） |
| `4.23` | ASG- | 未記載/×（追加配線しない） |
| `4.24` | BSG- | 未記載/×（追加配線しない） |

### U6 — AZD-K / D（D軸ドライバ）

| ピン識別子 | 図面信号名 | ネット/状態 |
|---|---|---|
| `4.1` | CW+ | N24 |
| `4.2` | CCW+ | N23 |
| `4.3` | IN4/ZHOME | N34 |
| `4.4` | IN6/STOP | 未記載/×（追加配線しない） |
| `4.5` | IN-COM_[4-7] | N03 |
| `4.6` | IN8/FW-JOG | 未記載/×（追加配線しない） |
| `4.7` | OUT0/HOME-END | 未記載/×（追加配線しない） |
| `4.8` | OUT2/PLS-RDY | 未記載/×（追加配線しない） |
| `4.9` | OUT4/MOVE | 未記載/×（追加配線しない） |
| `4.10` | OUT-COM | 未記載/×（追加配線しない） |
| `4.11` | ASG+ | 未記載/×（追加配線しない） |
| `4.12` | BSG+ | 未記載/×（追加配線しない） |
| `1.MB1` | MB1 | 未記載/×（追加配線しない） |
| `1.MB2` | MB2 | 未記載/×（追加配線しない） |
| `1.+` | + | N05 |
| `1.-` | - | N03 |
| `1.FG` | FG | 未記載/×（追加配線しない） |
| `4.13` | CW- | N26 |
| `4.14` | CCW- | N26 |
| `4.15` | IN5/FREE | 未記載/×（追加配線しない） |
| `4.16` | IN7/ALM-RST | 未記載/×（追加配線しない） |
| `4.17` | IN-COM_[8-9] | 未記載/×（追加配線しない） |
| `4.18` | IN9/RV-JOG | 未記載/×（追加配線しない） |
| `4.19` | OUT1/IN-POS | 未記載/×（追加配線しない） |
| `4.20` | OUT3/READY | 未記載/×（追加配線しない） |
| `4.21` | OUT5/ALM-B | 未記載/×（追加配線しない） |
| `4.22` | GND | 未記載/×（追加配線しない） |
| `4.23` | ASG- | 未記載/×（追加配線しない） |
| `4.24` | BSG- | 未記載/×（追加配線しない） |

## 9. ツールに依存しない再構成・受け渡し

### 9.1 他の回路CAD・作図プログラムでの手順

1. 第2節の40個を部品または外部端子付きモジュールとして作り、第8節の文字列ピン識別子をそのまま持たせる。抵抗・コンデンサーはSI値、ダイオードはK/Aを維持する。
2. 第7節の各N番号について、列挙された端子を全て同じノードへ接続する。ラベルでつなぐか線でつなぐかはツールに応じて選ぶ。別N番号を同色という理由でつながない。
3. 第8節の「未記載/×」へ外部ワイヤを付けない。空欄同士を共通ノードにまとめない。ボード内部のNRST・GND等の結線とは別の、外部配線の記録である。
4. リレーはHighでCOM–NOを閉じる機能ブロック、SW1は押した間だけ1–2を閉じる機能ブロックとして扱う。部品内部を電気シミュレータへ展開するには不足パラメータが必要で、この接続表だけで実機の過渡応答・入力電流まで再現できるわけではない。
5. 全40部品・278ピン・34接続ネット・131未記載ピンがあること、各ネットの端子集合が第7節と一致することを確かめる。接続の正しさは座標や線の描き方によらない。
6. 配色を適用する。物理レイアウトまで作る場合は、未指定のフットプリント・線径・定格・取付寸法等を先に確認する。図面上の座標を実装寸法へ変換しない。

### 9.2 汎用ファイル

| ファイル | 内容・読み方 |
|---|---|
| [wiring_manifest.json](wiring_manifest.json) | UTF-8の標準JSON。`components[].ref`と`pins[].pin`で端子を識別し、`pins[].net_id`と`connected_nets[].endpoints`で外部接続を定義。抵抗はΩ、容量はFの数値を`nominal_SI`へ記載。型番・機能・リレー接点・不足情報も収録。KiCad固有フィールドは無視しても接続を再現できる。 |
| [wiring_connections.csv](wiring_connections.csv) | UTF-8 BOM付き・カンマ区切り・1端子1行、278行。`ref,pin,terminal_name,net_id,status,signal_category,diagram_color`。`net_id`が同じ端子を接続。空欄は未記載で接続しない。`pin`は必ず文字列として読み込む。 |
| [hardware_bom.csv](hardware_bom.csv) | 同形式・1部品1行、40行。`ref,kind,recorded_value,role,resistance_ohm,capacitance_farad,pin_count`。抵抗値・容量以外の数値が空欄なら0ではなく未指定。 |

これらは特定CADの専用インポート形式ではない。ツールに応じて読み込みスクリプトで変換するか、表を見て手動配置する。元CADのネット名・クラス名・シンボル名・ファイルハッシュは出典を追う補足情報であり、接続定義に必要なものは部品・端子・N番号である。JSONの`null`は不明/未指定または未記載を示し、0や接地に読み替えない。本文の第1〜8節だけを他のAIへ渡しても、記録された外部回路を再構成できる。

### 9.3 KiCad固有の保存・表示情報

- KiCad 10.0.8で検証。元図は`hardware/SuperMEXE02.kicad_pro`、連続図は`hardware/continuous_wiring/SuperMEXE02_Continuous.kicad_pro`。いずれもA0横1189×841 mm・階層なしの1ページ。専用ライブラリー`SuperMEXE02_IO.kicad_sym`と相対参照`sym-lib-table`を同じフォルダーに置く。
- 専用シンボル名とピン数は第2・8節どおり。マイコンの30本をMCUチップ単体のピンへ置き換えない。AZD-KはCN4の24本とCN1の5本。CN2/CN3は説明文のみで内部ピンを作らない。リレー6端子、電源9端子を維持する。
- 元図は同名ラベルで離れた箇所を接続。連続図は全て線で接続し、ローカル名は各1個、グローバルラベル/子シートは0。連続図は299本の線分。交差だけの線は接続せず、接続点は丸で示す。
- 配線色はネットクラスGROUND=黒、POWER=赤、SENSOR=緑、CW=オレンジ、CCW=青、ZHOME=赤紫、VCT=青緑、UART=茶、RESET=灰。全34ネットへ割り当てる。正確なRGBAと各図のネット名は同梱JSONに記録。凡例も付ける。
- 色設定は`.kicad_pro`に保存される。ファイル単体ではなくプロジェクトから開く。「Highlight netclass colors」が有効だと周囲のハイライト表示となるため、配線自体を着色する場合は表示オプションでオフにする。
- 回路の電気的同一性は第7節が基準。見た目の座標・線の経路まで完全一致させる場合は、保存済みネイティブ回路図を使う。JSONの部品座標は元図の参照用で、実機の取付寸法・線の長さではない。

## 10. 実機の完全複製に不足している情報

図面上の不明を勝手に埋めない。以下は残った不足情報であり、図面から製造・実機動作を完全保証できない理由でもある。

- センサー1〜4の製造元・型番・IN/給電・実コネクター・出力範囲・校正。S1〜S4は実センサーそのものの型番ではない。
- NUCLEO実個体の基板リビジョン・ソルダーブリッジ（特にA4=PA5/PB7、A5=PA6/PA15、D13=PB3/PB8）とUSB/3V3内部給電設定。
- リレー基板の実ジャンパー位置・内部結線・個体リビジョン。6端子の外部配線のみ確定。
- AZD-Kの各軸個体・入力機能割当・パルス入力方式・電子ギヤ・原点復帰パラメータの実設定。2500 pulse/mmの採用換算はあるが設定バックアップ未収録。
- AZD-K CN2モータ・CN3エンコーダの個別接点とケーブル、CN1 MB1/MB2ブレーキ・FG、各電源AC L/N/PE・DC OKの実配線。図の×は実機で未使用の証明ではない。
- 抵抗/コンデンサーの許容差・定格・パッケージ、ダイオード実装形状、SW1型番と物理端子、基板/コネクター/線材/端末処理/配線長・実色。PCBフットプリント未指定。
- アクチュエータの個体対応・取付・原点/正負方向・押し面と受け台・チューブ材質寸法・循環流路の形状。
- 3.3 V直結CW/CCWと説明書5〜24 V指定の適合性、共有3V3の内部経路、実機の同期遅延・チャタリング・ノイズ・絶縁・精度の検証。

## 11. 根拠・機械可読データと照合

本書の端子表と全ネット一覧は、現行KiCadのXMLネットリスト・シンボル定義・ネットクラスから生成した。同梱[`wiring_manifest.json`](wiring_manifest.json)には同じ内容を構造化し、両図とライブラリーのSHA-256も記録した。部品・ピン・ネットを比較するAIは、画像の線を推測する代わりにこのJSONを読める。保存時の改行形式が変わるだけでもファイルハッシュは変わるため、電気的な同一性は部品ピン集合で比較する。

一次の確認根拠は利用者が2026-11-13までに説明した配線と提供写真・PDF、現行コード、同梱KiCad図。メーカーの初期信号名は実機のドライバ設定の確認済み値とは区別する。出典へのリンクや資料版は次の既存資料に残している。

- [全体仕様（機能・通信・停止条件）](../docs/SYSTEM_SPEC.md)
- [AZD-K・リレー・電源の資料と端子表](AZD_K_WIRING.md)
- [NUCLEOの公式資料と全端子対応](NUCLEO_G431KB_PINOUT.md)
- [基板間配線・コードとの関係](INTERCONNECTS.md)
- [元図の検証記録](checks/README.md) / [連続図の検証記録](continuous_wiring/checks/README.md)

照合手順：両図をKiCad XMLとして出力し、`verify_connections.py`で既知の配線を確認する。さらにJSONの全ネットを端子集合として比較し、全ピンを接続済みまたは外部配線未記載のどちらか一方へ分類できることを確認する。連続図は`continuous_wiring/verify_continuity.py`でラベル名に頼らない線の連続性も確認する。ERCは図面上の検査であり、第10節の実機未確認事項を解消する検査ではない。

## 12. 今後の更新時に維持すること

ハードの追加・変更時は、本文の部品表・全端子表・全ネット表、汎用JSON、2つのCSV、元図と連続図を同時に更新する。N番号はこの版の接続グループ識別子なので、改版時には番号だけで同一性を判定せず端子集合を比較する。接続変更と未確認事項の確定を区別し、資料にない情報は`null`または未確認として残す。変更後は全ピンの分類と両図の接続一致を再照合し、出典ハッシュ・確認日・システム仕様書の文書版を更新する。
