limonen-robot/SuperMEXE02/hardware/wiring_connections.csv

ref | pin | terminal_name | net_id | status | signal_category | diagram_color
C1 | 1 |  | N07 | connected | SENSOR | 緑
C1 | 2 |  | N26 | connected | GROUND | 黒
C2 | 1 |  | N08 | connected | SENSOR | 緑
C2 | 2 |  | N26 | connected | GROUND | 黒
C3 | 1 |  | N01 | connected | POWER | 赤
C3 | 2 |  | N26 | connected | GROUND | 黒
C4 | 1 |  | N01 | connected | POWER | 赤
C4 | 2 |  | N26 | connected | GROUND | 黒
C5 | 1 |  | N09 | connected | SENSOR | 緑
C5 | 2 |  | N26 | connected | GROUND | 黒
C6 | 1 |  | N10 | connected | SENSOR | 緑
C6 | 2 |  | N26 | connected | GROUND | 黒
D1 | 1 | K | N07 | connected | SENSOR | 緑
D1 | 2 | A | N26 | connected | GROUND | 黒
D2 | 1 | K | N08 | connected | SENSOR | 緑
D2 | 2 | A | N26 | connected | GROUND | 黒
D3 | 1 | K | N01 | connected | POWER | 赤
D3 | 2 | A | N07 | connected | SENSOR | 緑
D4 | 1 | K | N01 | connected | POWER | 赤
D4 | 2 | A | N08 | connected | SENSOR | 緑
D5 | 1 | K | N09 | connected | SENSOR | 緑
D5 | 2 | A | N26 | connected | GROUND | 黒
D6 | 1 | K | N01 | connected | POWER | 赤
D6 | 2 | A | N09 | connected | SENSOR | 緑
D7 | 1 | K | N10 | connected | SENSOR | 緑
D7 | 2 | A | N26 | connected | GROUND | 黒
D8 | 1 | K | N01 | connected | POWER | 赤
D8 | 2 | A | N10 | connected | SENSOR | 緑
K1 | VCC | VCC | N01 | connected | POWER | 赤
K1 | IN | IN | N12 | connected | VCT | 青緑
K1 | GND | GND | N26 | connected | GROUND | 黒
K1 | NC | NC |  | external_wiring_not_recorded
K1 | COM | COM | N01 | connected | POWER | 赤
K1 | NO | NO | N13 | connected | VCT | 青緑
K2 | VCC | VCC | N01 | connected | POWER | 赤
K2 | IN | IN | N16 | connected | ZHOME | 赤紫
K2 | GND | GND | N26 | connected | GROUND | 黒
K2 | NC | NC |  | external_wiring_not_recorded
K2 | COM | COM | N04 | connected | POWER | 赤
K2 | NO | NO | N31 | connected | ZHOME | 赤紫
K3 | VCC | VCC | N01 | connected | POWER | 赤
K3 | IN | IN | N19 | connected | ZHOME | 赤紫
K3 | GND | GND | N26 | connected | GROUND | 黒
K3 | NC | NC |  | external_wiring_not_recorded
K3 | COM | COM | N04 | connected | POWER | 赤
K3 | NO | NO | N32 | connected | ZHOME | 赤紫
K4 | VCC | VCC | N01 | connected | POWER | 赤
K4 | IN | IN | N22 | connected | ZHOME | 赤紫
K4 | GND | GND | N26 | connected | GROUND | 黒
K4 | NC | NC |  | external_wiring_not_recorded
K4 | COM | COM | N05 | connected | POWER | 赤
K4 | NO | NO | N33 | connected | ZHOME | 赤紫
K5 | VCC | VCC | N01 | connected | POWER | 赤
K5 | IN | IN | N25 | connected | ZHOME | 赤紫
K5 | GND | GND | N26 | connected | GROUND | 黒
K5 | NC | NC |  | external_wiring_not_recorded
K5 | COM | COM | N05 | connected | POWER | 赤
K5 | NO | NO | N34 | connected | ZHOME | 赤紫
PS1 | +V1 | +V1 | N04 | connected | POWER | 赤
PS1 | PE | PE |  | external_wiring_not_recorded
PS1 | +V2 | +V2 | N04 | connected | POWER | 赤
PS1 | -V1 | -V1 | N02 | connected | GROUND | 黒
PS1 | N | N |  | external_wiring_not_recorded
PS1 | -V2 | -V2 | N02 | connected | GROUND | 黒
PS1 | OK1 | DC_OK1 |  | external_wiring_not_recorded
PS1 | L | L |  | external_wiring_not_recorded
PS1 | OK2 | DC_OK2 |  | external_wiring_not_recorded
PS2 | +V1 | +V1 | N05 | connected | POWER | 赤
PS2 | PE | PE |  | external_wiring_not_recorded
PS2 | +V2 | +V2 | N05 | connected | POWER | 赤
PS2 | -V1 | -V1 | N03 | connected | GROUND | 黒
PS2 | N | N |  | external_wiring_not_recorded
PS2 | -V2 | -V2 | N03 | connected | GROUND | 黒
PS2 | OK1 | DC_OK1 |  | external_wiring_not_recorded
PS2 | L | L |  | external_wiring_not_recorded
PS2 | OK2 | DC_OK2 |  | external_wiring_not_recorded
R1 | 1 |  | N27 | connected | SENSOR | 緑
R1 | 2 |  | N07 | connected | SENSOR | 緑
R2 | 1 |  | N28 | connected | SENSOR | 緑
R2 | 2 |  | N08 | connected | SENSOR | 緑
R3 | 1 |  | N07 | connected | SENSOR | 緑
R3 | 2 |  | N26 | connected | GROUND | 黒
R4 | 1 |  | N08 | connected | SENSOR | 緑
R4 | 2 |  | N26 | connected | GROUND | 黒
R5 | 1 |  | N29 | connected | SENSOR | 緑
R5 | 2 |  | N09 | connected | SENSOR | 緑
R6 | 1 |  | N09 | connected | SENSOR | 緑
R6 | 2 |  | N26 | connected | GROUND | 黒
R7 | 1 |  | N30 | connected | SENSOR | 緑
R7 | 2 |  | N10 | connected | SENSOR | 緑
R8 | 1 |  | N10 | connected | SENSOR | 緑
R8 | 2 |  | N26 | connected | GROUND | 黒
S1 | OUT | OUT | N27 | connected | SENSOR | 緑
S1 | GND | GND | N26 | connected | GROUND | 黒
S2 | OUT | OUT | N28 | connected | SENSOR | 緑
S2 | GND | GND | N26 | connected | GROUND | 黒
S3 | OUT | OUT | N29 | connected | SENSOR | 緑
S3 | GND | GND | N26 | connected | GROUND | 黒
S4 | OUT | OUT | N30 | connected | SENSOR | 緑
S4 | GND | GND | N26 | connected | GROUND | 黒
SW1 | 1 | 1 | N06 | connected | RESET | 灰
SW1 | 2 | 2 | N26 | connected | GROUND | 黒
U1 | 4.1 | D1/PA9 | N11 | connected | UART | 茶
U1 | 4.2 | D0/PA10 |  | external_wiring_not_recorded
U1 | 4.3 | NRST | N06 | connected | RESET | 灰
U1 | 4.4 | GND | N26 | connected | GROUND | 黒
U1 | 4.5 | D2/PA12 |  | external_wiring_not_recorded
U1 | 4.6 | D3/PB0 | N13 | connected | VCT | 青緑
U1 | 4.7 | D4/PB7 |  | external_wiring_not_recorded
U1 | 4.8 | D5/PA15 |  | external_wiring_not_recorded
U1 | 4.9 | D6/PB6 |  | external_wiring_not_recorded
U1 | 4.10 | D7/PF0 |  | external_wiring_not_recorded
U1 | 4.11 | D8/PF1 |  | external_wiring_not_recorded
U1 | 4.12 | D9/PA8 |  | external_wiring_not_recorded
U1 | 4.13 | D10/PA11 |  | external_wiring_not_recorded
U1 | 4.14 | D11/PB5 |  | external_wiring_not_recorded
U1 | 4.15 | D12/PB4 |  | external_wiring_not_recorded
U1 | 3.1 | VIN |  | external_wiring_not_recorded
U1 | 3.2 | GND | N26 | connected | GROUND | 黒
U1 | 3.3 | NRST |  | external_wiring_not_recorded
U1 | 3.4 | +5V |  | external_wiring_not_recorded
U1 | 3.5 | A7/PA2 |  | external_wiring_not_recorded
U1 | 3.6 | A6/PA7 |  | external_wiring_not_recorded
U1 | 3.7 | A5/PA6/PA15 |  | external_wiring_not_recorded
U1 | 3.8 | A4/PA5/PB7 | N10 | connected | SENSOR | 緑
U1 | 3.9 | A3/PA4 | N09 | connected | SENSOR | 緑
U1 | 3.10 | A2/PA3 |  | external_wiring_not_recorded
U1 | 3.11 | A1/PA1 | N08 | connected | SENSOR | 緑
U1 | 3.12 | A0/PA0 | N07 | connected | SENSOR | 緑
U1 | 3.13 | AREF/AVDD |  | external_wiring_not_recorded
U1 | 3.14 | +3V3 | N01 | connected | POWER | 赤
U1 | 3.15 | D13/PB3/PB8 |  | external_wiring_not_recorded
U2 | 4.1 | D1/PA9 |  | external_wiring_not_recorded
U2 | 4.2 | D0/PA10 | N11 | connected | UART | 茶
U2 | 4.3 | NRST | N06 | connected | RESET | 灰
U2 | 4.4 | GND | N26 | connected | GROUND | 黒
U2 | 4.5 | D2/PA12 | N23 | connected | CCW | 青
U2 | 4.6 | D3/PB0 | N18 | connected | CW | オレンジ
U2 | 4.7 | D4/PB7 | N20 | connected | CCW | 青
U2 | 4.8 | D5/PA15 | N25 | connected | ZHOME | 赤紫
U2 | 4.9 | D6/PB6 | N21 | connected | CW | オレンジ
U2 | 4.10 | D7/PF0 |  | external_wiring_not_recorded
U2 | 4.11 | D8/PF1 |  | external_wiring_not_recorded
U2 | 4.12 | D9/PA8 | N17 | connected | CCW | 青
U2 | 4.13 | D10/PA11 | N24 | connected | CW | オレンジ
U2 | 4.14 | D11/PB5 | N19 | connected | ZHOME | 赤紫
U2 | 4.15 | D12/PB4 | N16 | connected | ZHOME | 赤紫
U2 | 3.1 | VIN |  | external_wiring_not_recorded
U2 | 3.2 | GND | N26 | connected | GROUND | 黒
U2 | 3.3 | NRST |  | external_wiring_not_recorded
U2 | 3.4 | +5V |  | external_wiring_not_recorded
U2 | 3.5 | A7/PA2 |  | external_wiring_not_recorded
U2 | 3.6 | A6/PA7 | N22 | connected | ZHOME | 赤紫
U2 | 3.7 | A5/PA6/PA15 |  | external_wiring_not_recorded
U2 | 3.8 | A4/PA5/PB7 |  | external_wiring_not_recorded
U2 | 3.9 | A3/PA4 | N14 | connected | CCW | 青
U2 | 3.10 | A2/PA3 |  | external_wiring_not_recorded
U2 | 3.11 | A1/PA1 | N15 | connected | CW | オレンジ
U2 | 3.12 | A0/PA0 | N12 | connected | VCT | 青緑
U2 | 3.13 | AREF/AVDD |  | external_wiring_not_recorded
U2 | 3.14 | +3V3 | N01 | connected | POWER | 赤
U2 | 3.15 | D13/PB3/PB8 |  | external_wiring_not_recorded
U3 | 4.1 | CW+ | N15 | connected | CW | オレンジ
U3 | 4.2 | CCW+ | N14 | connected | CCW | 青
U3 | 4.3 | IN4/ZHOME | N31 | connected | ZHOME | 赤紫
U3 | 4.4 | IN6/STOP |  | external_wiring_not_recorded
U3 | 4.5 | IN-COM_[4-7] | N02 | connected | GROUND | 黒
U3 | 4.6 | IN8/FW-JOG |  | external_wiring_not_recorded
U3 | 4.7 | OUT0/HOME-END |  | external_wiring_not_recorded
U3 | 4.8 | OUT2/PLS-RDY |  | external_wiring_not_recorded
U3 | 4.9 | OUT4/MOVE |  | external_wiring_not_recorded
U3 | 4.10 | OUT-COM |  | external_wiring_not_recorded
U3 | 4.11 | ASG+ |  | external_wiring_not_recorded
U3 | 4.12 | BSG+ |  | external_wiring_not_recorded
U3 | 1.MB1 | MB1 |  | external_wiring_not_recorded
U3 | 1.MB2 | MB2 |  | external_wiring_not_recorded
U3 | 1.+ | + | N04 | connected | POWER | 赤
U3 | 1.- | - | N02 | connected | GROUND | 黒
U3 | 1.FG | FG |  | external_wiring_not_recorded
U3 | 4.13 | CW- | N26 | connected | GROUND | 黒
U3 | 4.14 | CCW- | N26 | connected | GROUND | 黒
U3 | 4.15 | IN5/FREE |  | external_wiring_not_recorded
U3 | 4.16 | IN7/ALM-RST |  | external_wiring_not_recorded
U3 | 4.17 | IN-COM_[8-9] |  | external_wiring_not_recorded
U3 | 4.18 | IN9/RV-JOG |  | external_wiring_not_recorded
U3 | 4.19 | OUT1/IN-POS |  | external_wiring_not_recorded
U3 | 4.20 | OUT3/READY |  | external_wiring_not_recorded
U3 | 4.21 | OUT5/ALM-B |  | external_wiring_not_recorded
U3 | 4.22 | GND |  | external_wiring_not_recorded
U3 | 4.23 | ASG- |  | external_wiring_not_recorded
U3 | 4.24 | BSG- |  | external_wiring_not_recorded
U4 | 4.1 | CW+ | N18 | connected | CW | オレンジ
U4 | 4.2 | CCW+ | N17 | connected | CCW | 青
U4 | 4.3 | IN4/ZHOME | N32 | connected | ZHOME | 赤紫
U4 | 4.4 | IN6/STOP |  | external_wiring_not_recorded
U4 | 4.5 | IN-COM_[4-7] | N02 | connected | GROUND | 黒
U4 | 4.6 | IN8/FW-JOG |  | external_wiring_not_recorded
U4 | 4.7 | OUT0/HOME-END |  | external_wiring_not_recorded
U4 | 4.8 | OUT2/PLS-RDY |  | external_wiring_not_recorded
U4 | 4.9 | OUT4/MOVE |  | external_wiring_not_recorded
U4 | 4.10 | OUT-COM |  | external_wiring_not_recorded
U4 | 4.11 | ASG+ |  | external_wiring_not_recorded
U4 | 4.12 | BSG+ |  | external_wiring_not_recorded
U4 | 1.MB1 | MB1 |  | external_wiring_not_recorded
U4 | 1.MB2 | MB2 |  | external_wiring_not_recorded
U4 | 1.+ | + | N04 | connected | POWER | 赤
U4 | 1.- | - | N02 | connected | GROUND | 黒
U4 | 1.FG | FG |  | external_wiring_not_recorded
U4 | 4.13 | CW- | N26 | connected | GROUND | 黒
U4 | 4.14 | CCW- | N26 | connected | GROUND | 黒
U4 | 4.15 | IN5/FREE |  | external_wiring_not_recorded
U4 | 4.16 | IN7/ALM-RST |  | external_wiring_not_recorded
U4 | 4.17 | IN-COM_[8-9] |  | external_wiring_not_recorded
U4 | 4.18 | IN9/RV-JOG |  | external_wiring_not_recorded
U4 | 4.19 | OUT1/IN-POS |  | external_wiring_not_recorded
U4 | 4.20 | OUT3/READY |  | external_wiring_not_recorded
U4 | 4.21 | OUT5/ALM-B |  | external_wiring_not_recorded
U4 | 4.22 | GND |  | external_wiring_not_recorded
U4 | 4.23 | ASG- |  | external_wiring_not_recorded
U4 | 4.24 | BSG- |  | external_wiring_not_recorded
U5 | 4.1 | CW+ | N21 | connected | CW | オレンジ
U5 | 4.2 | CCW+ | N20 | connected | CCW | 青
U5 | 4.3 | IN4/ZHOME | N33 | connected | ZHOME | 赤紫
U5 | 4.4 | IN6/STOP |  | external_wiring_not_recorded
U5 | 4.5 | IN-COM_[4-7] | N03 | connected | GROUND | 黒
U5 | 4.6 | IN8/FW-JOG |  | external_wiring_not_recorded
U5 | 4.7 | OUT0/HOME-END |  | external_wiring_not_recorded
U5 | 4.8 | OUT2/PLS-RDY |  | external_wiring_not_recorded
U5 | 4.9 | OUT4/MOVE |  | external_wiring_not_recorded
U5 | 4.10 | OUT-COM |  | external_wiring_not_recorded
U5 | 4.11 | ASG+ |  | external_wiring_not_recorded
U5 | 4.12 | BSG+ |  | external_wiring_not_recorded
U5 | 1.MB1 | MB1 |  | external_wiring_not_recorded
U5 | 1.MB2 | MB2 |  | external_wiring_not_recorded
U5 | 1.+ | + | N05 | connected | POWER | 赤
U5 | 1.- | - | N03 | connected | GROUND | 黒
U5 | 1.FG | FG |  | external_wiring_not_recorded
U5 | 4.13 | CW- | N26 | connected | GROUND | 黒
U5 | 4.14 | CCW- | N26 | connected | GROUND | 黒
U5 | 4.15 | IN5/FREE |  | external_wiring_not_recorded
U5 | 4.16 | IN7/ALM-RST |  | external_wiring_not_recorded
U5 | 4.17 | IN-COM_[8-9] |  | external_wiring_not_recorded
U5 | 4.18 | IN9/RV-JOG |  | external_wiring_not_recorded
U5 | 4.19 | OUT1/IN-POS |  | external_wiring_not_recorded
U5 | 4.20 | OUT3/READY |  | external_wiring_not_recorded
U5 | 4.21 | OUT5/ALM-B |  | external_wiring_not_recorded
U5 | 4.22 | GND |  | external_wiring_not_recorded
U5 | 4.23 | ASG- |  | external_wiring_not_recorded
U5 | 4.24 | BSG- |  | external_wiring_not_recorded
U6 | 4.1 | CW+ | N24 | connected | CW | オレンジ
U6 | 4.2 | CCW+ | N23 | connected | CCW | 青
U6 | 4.3 | IN4/ZHOME | N34 | connected | ZHOME | 赤紫
U6 | 4.4 | IN6/STOP |  | external_wiring_not_recorded
U6 | 4.5 | IN-COM_[4-7] | N03 | connected | GROUND | 黒
U6 | 4.6 | IN8/FW-JOG |  | external_wiring_not_recorded
U6 | 4.7 | OUT0/HOME-END |  | external_wiring_not_recorded
U6 | 4.8 | OUT2/PLS-RDY |  | external_wiring_not_recorded
U6 | 4.9 | OUT4/MOVE |  | external_wiring_not_recorded
U6 | 4.10 | OUT-COM |  | external_wiring_not_recorded
U6 | 4.11 | ASG+ |  | external_wiring_not_recorded
U6 | 4.12 | BSG+ |  | external_wiring_not_recorded
U6 | 1.MB1 | MB1 |  | external_wiring_not_recorded
U6 | 1.MB2 | MB2 |  | external_wiring_not_recorded
U6 | 1.+ | + | N05 | connected | POWER | 赤
U6 | 1.- | - | N03 | connected | GROUND | 黒
U6 | 1.FG | FG |  | external_wiring_not_recorded
U6 | 4.13 | CW- | N26 | connected | GROUND | 黒
U6 | 4.14 | CCW- | N26 | connected | GROUND | 黒
U6 | 4.15 | IN5/FREE |  | external_wiring_not_recorded
U6 | 4.16 | IN7/ALM-RST |  | external_wiring_not_recorded
U6 | 4.17 | IN-COM_[8-9] |  | external_wiring_not_recorded
U6 | 4.18 | IN9/RV-JOG |  | external_wiring_not_recorded
U6 | 4.19 | OUT1/IN-POS |  | external_wiring_not_recorded
U6 | 4.20 | OUT3/READY |  | external_wiring_not_recorded
U6 | 4.21 | OUT5/ALM-B |  | external_wiring_not_recorded
U6 | 4.22 | GND |  | external_wiring_not_recorded
U6 | 4.23 | ASG- |  | external_wiring_not_recorded
U6 | 4.24 | BSG- |  | external_wiring_not_recorded
