limonen-robot/SuperMEXE02/hardware/AZD_K_WIRING.md

# AZD-K・リレー・24 V電源の端子と実配線

利用者確認：2026-11-13。ファームウェアとPCアプリは変更していません。

全部品の全接続先・未記載端子・配色を省略なく読む場合は[文字による再現仕様](HARDWARE_REPRODUCTION.md)と[機械可読JSON](wiring_manifest.json)を参照してください。CN4の図上の左右配置はシンボルの配置であり、差込面と電線側を含む実コネクターの物理向きを確定する記録ではありません。

## 1ページの配置

`SuperMEXE02.kicad_pro`を開くと、A0横の1ページ全体を編集できます。[全体プレビュー](previews/sensor_frontend.png)／[拡大可能なSVG](previews/SuperMEXE02.svg)。

- 左：両NUCLEO、4入力、共通リセット、UART線、VCT用リレーK1。
- 右上：A・B軸のAZD-K U3/U4、ZHOMEリレーK2/K3、電源PS1。
- 右下：C・D軸のAZD-K U5/U6、ZHOMEリレーK4/K5、電源PS2。

階層シートは廃止し、すべて同じページに配置しました。同名のグローバルラベルは同じ電気接続を表します。統合前後ですべてのネットの部品ピン集合が一致することを確認し、配線の変更はありません。

## AZD-K：CN4全24端子

提供された「HM-60313J (1).pdf」（文書版HM-60313-7）の18ページにあるパルス列入力タイプの割当を使用。左列上から1〜12、右列上から13〜24。KiCadでは `4.n` をCN4のn番として記載しています。括弧相当の機能名は初期割当で、MEXE02による変更は未確認です。

| CN4番号 | 信号・初期割当 |
|---|---|
| 1 | CW+ |
| 2 | CCW+ |
| 3 | IN4 / ZHOME |
| 4 | IN6 / STOP |
| 5 | IN-COM [4-7] |
| 6 | IN8 / FW-JOG |
| 7 | OUT0 / HOME-END |
| 8 | OUT2 / PLS-RDY |
| 9 | OUT4 / MOVE |
| 10 | OUT-COM |
| 11 | ASG+ |
| 12 | BSG+ |
| 13 | CW- |
| 14 | CCW- |
| 15 | IN5 / FREE |
| 16 | IN7 / ALM-RST |
| 17 | IN-COM [8-9] |
| 18 | IN9 / RV-JOG |
| 19 | OUT1 / IN-POS |
| 20 | OUT3 / READY |
| 21 | OUT5 / ALM-B |
| 22 | GND |
| 23 | ASG- |
| 24 | BSG- |

## CN1と、今回ピンを展開していないコネクタ

CN1は上からMB1・MB2・＋・−・FGの5点を表示。電源は＋／−へ接続し、MB1/MB2とFGの実配線はまだ未説明です。これらはメーカーの端子表示をそのまま識別子 `1.MB1` 等へ使い、数字のピン番号を創作していません。

CN2＝モータ、CN3＝エンコーダ、USB＝MEXE02用の接続口があります。今回の説明書にはCN2/CN3の接点ごとの信号割当がないため、CN2/CN3は名称表示にとどめています。全接点を確定した完全な製造用図面ではありません。型番不明の内部接点や未説明のモータ・ブレーキ配線を推定していません。

## 5番IN-COMとは

**IN-COM[4–7]はIN4〜IN7の入力回路に共通の端子**です。今回の配線は次の電流経路になります。

`24 V＋ → リレーCOM →（接点ON）→ NO → CN4-3 IN4/ZHOME → 内部フォトカプラ入力 → CN4-5 IN-COM → 24 V−`

5番は、今回の回路では24 V−へ接続する戻り端子です。一般にIN-COMという名前だけで常にGNDに固定されるわけではなく、入力の接続方式によります。22番GNDとは別端子で、今回22番に24 V−をつないでいません。17番はIN8/9用の別の入力コモンで、今回の図では配線未記載です。

## 軸ごとのGPIO

| 軸 | CW＋に直結 | CCW＋に直結 | ZHOMEリレーIN | ドライバ | リレー | 電源 |
|---|---|---|---|---|---|
| A | PA1 / A1 | PA4 / A3 | PB4 / D12 | U3 | K2 | PS1 |
| B | PB0 / D3 | PA8 / D9 | PB5 / D11 | U4 | K3 | PS1 |
| C | PB6 / D6 | PB7 / D4 | PA7 / A6 | U5 | K4 | PS2 |
| D | PA11 / D10 | PA12 / D2 | PA15 / D5 | U6 | K5 | PS2 |

GPIO割当は現行motorコードを参照。CW−（CN4-13）とCCW−（CN4-14）はすべてマイコン側GNDです。抵抗・トランジスタ・レベル変換回路は実機にないとの利用者確認に従い追加していません。

**実配線の記録と適合性の検証は区別しています。** 説明書20ページはCW/CCW入力をDC5〜24 Vと指定しますが、実機は3.3 V GPIO直結です。その差を注記し、改造案へ置き換えていません。ドライバの内部絶縁、電源間の電位・電流、入力電流をシミュレーションしたものではありません。

## QCCAN QC19004 リレー基板

販売型番はQCCAN QC19004、ASIN B09X1P3YHL。写真のリレー本体はBESTEP JQC3F-03VDC-C。販売ページでは3/3.3 V給電、High入力で作動するタイプです。基板全体を6端子のシンボルで表し、裸コイルをGPIOへ直結する図ではありません。

部品面を上にし、制御側を左に置いた向きの端子順：

| 上から | 左：制御側 | 右：接点側 |
|---|---|---|
| 1段目 | VCC | NC |
| 2段目 | IN | COM |
| 3段目 | GND | NO |

これは物理的な上下の位置を表し、メーカーが付けた1〜6の端子番号ではありません。KiCadの端子識別子はVCC/IN/GND/NC/COM/NOです。ジャンパーは商品写真で存在を確認しましたが、内部接続や実機の設定は未確定のため、内部回路として展開していません。

- K1（VCT）：VCC/COM＝共通3V3、GND＝マイコンGND、IN＝motor PA0、NO＝sensor PB0。
- K2〜K5（ZHOME）：VCC＝共通3V3、GND＝マイコンGND、IN＝各ZHOME GPIO、COM＝対応する24 V＋、NO＝対応AZD-KのCN4-3。
- NCは使わない接点として表示。NOはERC上、切替後の駆動出力として分類しており、接点の開閉を電気的にシミュレーションしていません。

出典：[同一ASINの販売ページ](https://www.amazon.com/dp/B09X1P3YHL)／[端子印字を確認した商品画像](https://m.media-amazon.com/images/I/61G9igaKVnL._SL500_.jpg)。

## MEAN WELL MDR-100-24：2台の分配

| 電源 | 接続軸 | ＋側の負荷 | −側の負荷 |
|---|---|---|---|
| PS1 | A・B | U3/U4のCN1＋、K2/K3のCOM | U3/U4のCN1−、CN4-5 |
| PS2 | C・D | U5/U6のCN1＋、K4/K5のCOM | U5/U6のCN1−、CN4-5 |

電源の各＋端子へ2本、各−端子へ2本を入れ、1ドライバの電源とZHOME回路へ分ける実配線を記録。同じ電源内の2つの＋端子は同じ出力、2つの−端子も同じ出力なので、図では同じネット名を使用しています。端子穴へ2本を挿すという機械的な結線方法の適否を検証したものではありません。

電源PS1は24V_AB/0V_AB、PS2は24V_CD/0V_CD。**0V_AB・0V_CD・マイコンGNDは、相互に接続していません。** 接点のCOM側と、制御側VCC/GNDを混同しないように分けています。AC入力L/N/PE、DC OK状態接点、各ドライバのFGの実配線は未記載です。

電源は24 V・4 A（96 W）。上側は＋V×2・−V×2・DC OK×2、下側はPE・N・Lの順に銘板写真をもとに配置。+V1/+V2等はプロジェクトでの識別名です。DC OKは状態出力接点で、主電源出力端子ではありません。

出典：[MEAN WELL公式仕様書](https://www.meanwell.com/Upload/PDF/MDR-100/MDR-100-SPEC.PDF)、利用者提供銘板写真。AZD-Kは[メーカー製品ページ](https://www.orientalmotor.co.jp/ja/products/detail?hinmei=AZD-K)も参照。
