limonen-robot/SuperMEXE02/hardware/SuperMEXE02.kicad_sch

## KiCad design hardware/SuperMEXE02.kicad_sch (2026-11-13)

Schematic: SuperMEXE02.kicad_sch

Parts:
C1, C2, C3, C5, C6: 0.1u
C4: 1u
D1, D2, D3, D4, D5, D6, D7, D8: 1N4148; D_DO-35_SOD27_P7.62mm_Horizontal
K1: QC19004 / VCT
K2: QC19004 / ZHOME A
K3: QC19004 / ZHOME B
K4: QC19004 / ZHOME C
K5: QC19004 / ZHOME D
PS1: MDR-100-24 / AB
PS2: MDR-100-24 / CD
R1, R2, R5, R7: 510
R3, R4, R6, R8: 47k
S1: sensor1
S2: sensor2
S3: sensor3
S4: sensor4
SW1: RESET BOTH
U1: NUCLEO-G431KB
U2: NUCLEO-G431KB (motor)
U3: AZD-K / A
U4: AZD-K / B
U5: AZD-K / C
U6: AZD-K / D

Connections:
0V_AB: PS1.-V1, PS1.-V2, U3.1.- (-), U3.4.5 (IN-COM [4-7]), U4.1.- (-), U4.4.5 (IN-COM [4-7])
0V_CD: PS2.-V1, PS2.-V2, U5.1.- (-), U5.4.5 (IN-COM [4-7]), U6.1.- (-), U6.4.5 (IN-COM [4-7])
24V_AB: K2.COM, K3.COM, PS1.+V1, PS1.+V2, U3.1.+ (+), U4.1.+ (+)
24V_CD: K4.COM, K5.COM, PS2.+V1, PS2.+V2, U5.1.+ (+), U6.1.+ (+)
+3V3: C3.1, C4.1, D3.1 (K), D4.1 (K), D6.1 (K), D8.1 (K), K1.COM, K1.VCC, K2.VCC, K3.VCC, K4.VCC, K5.VCC, U1.3.14 (+3V3), U2.3.14 (+3V3)
A_CCW: U2.3.9 (A3/PA4), U3.4.2 (CCW+)
A_CW: U2.3.11 (A1/PA1), U3.4.1 (CW+)
A_HOME: K2.IN, U2.4.15 (D12/PB4)
B_CCW: U2.4.12 (D9/PA8), U4.4.2 (CCW+)
B_CW: U2.4.6 (D3/PB0), U4.4.1 (CW+)
B_HOME: K3.IN, U2.4.14 (D11/PB5)
C_CCW: U2.4.7 (D4/PB7), U5.4.2 (CCW+)
C_CW: U2.4.9 (D6/PB6), U5.4.1 (CW+)
C_HOME: K4.IN, U2.3.6 (A6/PA7)
D_CCW: U2.4.5 (D2/PA12), U6.4.2 (CCW+)
D_CW: U2.4.13 (D10/PA11), U6.4.1 (CW+)
D_HOME: K5.IN, U2.4.8 (D5/PA15)
GND: C1.2, C2.2, C3.2, C4.2, C5.2, C6.2, D1.2 (A), D2.2 (A), D5.2 (A), D7.2 (A), K1.GND, K2.GND, K3.GND, K4.GND, K5.GND, R3.2, R4.2, R6.2, R8.2, S1.GND, S2.GND, S3.GND, S4.GND, SW1.2, U1.3.2 (GND), U1.4.4 (GND), U2.3.2 (GND), U2.4.4 (GND), U3.4.13 (CW-), U3.4.14 (CCW-), U4.4.13 (CW-), U4.4.14 (CCW-), U5.4.13 (CW-), U5.4.14 (CCW-), U6.4.13 (CW-), U6.4.14 (CCW-)
NRST_BOTH: SW1.1, U1.4.3 (NRST), U2.4.3 (NRST)
unnamed: K2.NO, U3.4.3 (IN4/ZHOME)
unnamed: K3.NO, U4.4.3 (IN4/ZHOME)
unnamed: K4.NO, U5.4.3 (IN4/ZHOME)
unnamed: K5.NO, U6.4.3 (IN4/ZHOME)
unnamed: R1.1, S1.OUT
unnamed: R2.1, S2.OUT
unnamed: R5.1, S3.OUT
unnamed: R7.1, S4.OUT
SENSOR1_ADC_PA0: C1.1, D1.1 (K), D3.2 (A), R1.2, R3.1, U1.3.12 (A0/PA0)
SENSOR2_ADC_PA1: C2.1, D2.1 (K), D4.2 (A), R2.2, R4.1, U1.3.11 (A1/PA1)
SENSOR3_ADC_PA4: C5.1, D5.1 (K), D6.2 (A), R5.2, R6.1, U1.3.9 (A3/PA4)
SENSOR4_ADC_PA5: C6.1, D7.1 (K), D8.2 (A), R7.2, R8.1, U1.3.8 (A4/PA5/PB7)
SENSOR_D1_TO_MOTOR_D0: U1.4.1 (D1/PA9), U2.4.2 (D0/PA10)
VCT_RELAY_CTRL: K1.IN, U2.3.12 (A0/PA0)
VCT_TO_SENSOR_PB0: K1.NO, U1.4.6 (D3/PB0)

Notes on the sheet:
CONTROL / MOTOR + SENSOR
Component side, USB at top. Left: CN4 / Right: CN3. 3.n / 4.n = header pin number.
CN4
CN3
USB / ST-LINK
NUCLEO-G431KB
USB powered
A4: PA5/PB7 and A5: PA6/PA15 depend on solder bridges; actual board settings unconfirmed.
IN/excitation omitted. Crossings without a dot are not connected.
ST UM2397 Rev 2, Figure 12 / Table 11. 30 Arduino header pins; USB connector is shown as a legend.
MOTOR / U2
SENSOR / U1
K1: PA0 HIGH closes COM -> NO; shared 3V3 reaches sensor PB0.
K1 / K2-K5: QCCAN QC19004; VCC=3V3, GND=MCU ground. Contacts have separate voltage domains.
Both USB powered; shared 3V3 is recorded as existing wiring. Rail sourcing/configuration not validated.
D1 -> D0 wire is physically present; current firmware does not use this UART. No firmware changes.
RESET BOTH is represented as a normally-open switch to GND; switch model not specified.
AZD-K / AXES AB / isolated 24V supply domain
CN4: all 24 pins. CN1: all five terminals. Matching labels are connected on this sheet.
A / AZD-K
CN2 motor / CN3 encoder
Pin assignments not specified
CN1
B / AZD-K
24V negative is connected to CN4-5 (IN-COM[4-7]), NOT CN4-22 (GND).
CW/CCW plus: direct 3.3V GPIO. Minus: MCU GND. No interface parts (as-built).
Manual specifies 5-24V pulse inputs; 3.3V operation is outside that voltage specification.
AC/PE, motor, encoder, brake and other I/O wiring not yet recorded. X = not drawn, not confirmed unused.
AZD-K / AXES CD / isolated 24V supply domain
C / AZD-K
D / AZD-K
SuperMEXE02 / COMPLETE HARDWARE ON ONE SHEET
Two NUCLEO-G431KB boards / four AZD-K drives / five QC19004 relays / two MDR-100-24 supplies
A/B: PS1, 24V_AB and 0V_AB. C/D: PS2, 24V_CD and 0V_CD. Both 24V negative rails remain separate from MCU GND.
CONNECTION GUIDE
All components and all recorded wiring are on this page. There are no child sheets.
Identical labels are electrical connections; a long drawn wire is not required between equal labels.
A_CW/A_CCW/A_HOME link the motor MCU to axis A; B/C/D use the same naming rule.
GND and +3V3 are the shared MCU supply references. 0V_AB and 0V_CD are independent 24V returns.
CN4-5 is IN-COM[4-7]. CN4-22 is a different GND terminal and is not used as the ZHOME return.
Pin assignments and component values are unchanged from revision 0.5.
Native KiCad and SVG are scalable; zoom in to inspect the full pin labels.
GROUND : GND / 24 V return
POWER : 3V3 / +24 V
SENSOR : Sensor analog
CW : CW
CCW : CCW
ZHOME : ZHOME
VCT : VCT
UART : UART
RESET : RESET
