limonen-robot/SuperMEXE02/(commit log)

2026-11-01 G431KB二台仕様のフォルダ構成
2026-11-01 sensorマイコン無しで動く範囲をすべて網羅
2026-11-11 docs: 更新後にコミットとpushを行う運用ルールを追加
2026-11-11 feat: センサー計測とPID制御・指令位置表示を追加
    4系列のセンサー取得、VCT同期サンプリング、数式とCSVによる目標値生成を追加。
    最大3系統のPID制御をmotor側に実装し、ZHOMEと初期位置移動後に開始する。
    フィードバックのCCW位置下限を撤廃し、指令積算位置と停止時の位置を表示する。
    設定保存・復元、センサー通信開始時の再同期、モニター表示、使用手順を追加。
    変換表CSVを収録し、mbed-os.libから復元できるMbed OS本体をGit対象外とする。
    検証: アプリの自動テスト89件成功、motor・sensor両方のビルド成功。
    [alpha_beta_書式例.csv, 旧コード_冠灌流圧_目標流量.csv, 脳循環0.7L_min一定.csv]
2026-11-11 docs: ハード構成・配線・制御をまとめたシステム仕様書を追加
    motor/sensorの全ピン割当、電源・VCT・ZHOME接続、機器構成を記載。
    計測・PID・通信・保存・停止条件と、研究目標に対する実装範囲を整理。
    実測換算とメーカー仕様の差、未確認の回路・機械・校正事項を明記。
    ルートREADMEを現行システムの説明に更新し、仕様書への導線を追加。
    確認: 文書内リンク、コードブロック、ファームウェア版、通信コマンド名、差分チェック。
2026-11-13 docs: KiCad 10のMCP導入・診断手順を追加
2026-11-13 feat: sensor側4入力のKiCad回路図と機器型番の記録を追加
    [SuperMEXE02.kicad_sch]
2026-11-13 fix: G431KBと4入力および共通電源を直接配線した回路図に整理
    [SuperMEXE02.kicad_sch]
2026-11-13 feat: G431KB基板の左右全30端子を実配置に合わせて図面化
    [SuperMEXE02.kicad_sch]
2026-11-13 feat: motor基板とVCTリレー・UART・共通リセットの実配線を追加
    [SuperMEXE02.kicad_sch]
2026-11-13 feat: AZD-K4軸と電源2系統・全端子リレーの回路図を追加
    [Drives_AB.kicad_sch, Drives_CD.kicad_sch, SuperMEXE02.kicad_sch]
2026-11-13 refactor: 全機器のKiCad回路図をA0横1ページへ統合
    [Drives_AB.kicad_sch, Drives_CD.kicad_sch, SuperMEXE02.kicad_sch]
2026-11-13 feat: 元図を保持し全配線を線でつないだ連続配線図を追加
    [SuperMEXE02_Continuous.kicad_sch]
2026-11-13 feat: 連続配線図を信号種別ごとに色分け
    [SuperMEXE02_Continuous.kicad_sch]
2026-11-13 feat: 元図にも色分けを適用しCWオレンジ・CCW青に統一
    [SuperMEXE02.kicad_sch, SuperMEXE02_Continuous.kicad_sch]
2026-11-13 docs: CADに依存しない回路再現仕様と全端子CSV・JSONを追加
    [hardware_bom.csv, wiring_connections.csv]
2026-11-13 実機C++と元Pythonアプリを使う仮想マイコン実行基盤を追加
